Samprab06/PiPod/assets/demo_art/art_1.png

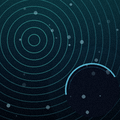
assets/demo_art/art_1.png
