Samprab06/PiPod/assets/demo_art/art_4.png

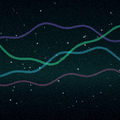
assets/demo_art/art_4.png
