Samprab06/PiPod/assets/demo_art/art_5.png

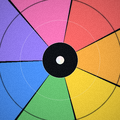
assets/demo_art/art_5.png
