Samprab06/PiPod/hardware/PiPod_BOM.csv

Category | References | Qty | Value | Manufacturer | MPN | Supplier | Supplier SKU | Datasheet URL | KiCad Symbol | KiCad Footprint | Package | Ratings | Populated/DNP | Verification Status | Notes
Mandatory | C1, C2, C3, C20 | 4 | 4.7u | KEMET | C0603C475K8PACTU | Digi-Key | 399-C0603C475K8PACTUTR-ND |  | Device:C | Capacitor_SMD:C_0603_1608Metric | 0603 | 10 V X5R | Populated | datasheet-checked | 2026-11-01/02 snapshot: stock 125,154; recheck before ordering
Mandatory | C4, C31, C32, C42, C43, C44, C50, C60, C71, C73, C75, C77 | 12 | 10u | Taiyo Yuden | EMK212ABJ106KD-T | Digi-Key |  |  | Device:C | Capacitor_SMD:C_0805_2012Metric | 0805 | 16 V X5R | Populated | datasheet-checked | 2026-11-01/02 snapshot: stock 55,760; recheck before ordering
Mandatory | C5, C6 | 2 | 15p | Murata | GRM1885C2A150JA01D | Digi-Key | 490-1331-2-ND |  | Device:C | Capacitor_SMD:C_0603_1608Metric | 0603 | 100 V C0G | Populated | datasheet-checked | 2026-11-01/02 snapshot: stock 645,869; recheck before ordering
Mandatory | C21, C33, C45, C46, C51, C61, C72, C74, C76, C78, C80, C100, C101, C102, C103, C104, C105, C106, C107, C108, C109, C110, C111, C112 | 24 | 100n | KEMET | C0603C104K4RACTU | Digi-Key |  |  | Device:C | Capacitor_SMD:C_0603_1608Metric | 0603 | 16 V X7R | Populated | datasheet-checked | 2026-11-01/02 snapshot: stock 7,248,230; recheck before ordering
Mandatory | C22, C40, C41, C79 | 4 | 22u | Taiyo Yuden | LMK212BJ226MG-T | Digi-Key | 587-1958-1-ND |  | Device:C | Capacitor_SMD:C_0805_2012Metric | 0805 | 10 V X5R | Populated | datasheet-checked | 2026-11-01/02 snapshot: stock 525,170, status Not For New Designs; recheck before ordering
Mandatory | C30, C70, C90, C91 | 4 | 1u | KEMET | C0603C105K4RACTU | Digi-Key |  |  | Device:C | Capacitor_SMD:C_0603_1608Metric | 0603 | 16 V X7R | Populated | datasheet-checked | 2026-11-01/02 snapshot: stock not read; recheck before ordering
Mandatory | C81, C82 | 2 | 100u | Taiyo Yuden | LMK325BJ107MM-T | Digi-Key | 587-1965-2-ND |  | Device:C | Capacitor_SMD:C_1210_3225Metric | 1210 | 10 V X5R | Populated | datasheet-checked | 2026-11-01/02 snapshot: stock 92,909; recheck before ordering
Mandatory | D1 | 1 | GREEN | Lite-On | LTST-C171KGKT | Digi-Key | 160-1426-2-ND |  | Device:LED | LED_SMD:LED_0805_2012Metric | 0805 |  | Populated | same part as Proton Rev4 | 2026-11-01/02 snapshot: stock 400,708; recheck before ordering
Mandatory | D2 | 1 | SMF5.0A | Littelfuse | SMF5.0A | Digi-Key |  |  | Device:D_Zener | Diode_SMD:D_SMF | SMF | 5 V standoff | Populated | needs human check | 2026-11-01/02 snapshot: stock not read; recheck before ordering
Mandatory | E1 | 1 | E0 |  |  |  |  |  | Connector:TestPoint | PiPod:WheelElectrode_Placeholder | PCB electrode |  | Populated | layout dependency | No part
Mandatory | E2 | 1 | E1 |  |  |  |  |  | Connector:TestPoint | PiPod:WheelElectrode_Placeholder | PCB electrode |  | Populated | layout dependency | No part
Mandatory | E3 | 1 | E2 |  |  |  |  |  | Connector:TestPoint | PiPod:WheelElectrode_Placeholder | PCB electrode |  | Populated | layout dependency | No part
Mandatory | E4 | 1 | E3 |  |  |  |  |  | Connector:TestPoint | PiPod:WheelElectrode_Placeholder | PCB electrode |  | Populated | layout dependency | No part
Mandatory | E5 | 1 | E4 |  |  |  |  |  | Connector:TestPoint | PiPod:WheelElectrode_Placeholder | PCB electrode |  | Populated | layout dependency | No part
Mandatory | E6 | 1 | E5 |  |  |  |  |  | Connector:TestPoint | PiPod:WheelElectrode_Placeholder | PCB electrode |  | Populated | layout dependency | No part
Mandatory | E7 | 1 | E6 |  |  |  |  |  | Connector:TestPoint | PiPod:WheelElectrode_Placeholder | PCB electrode |  | Populated | layout dependency | No part
Mandatory | E8 | 1 | E7 |  |  |  |  |  | Connector:TestPoint | PiPod:WheelElectrode_Placeholder | PCB electrode |  | Populated | layout dependency | No part
Mandatory | E9 | 1 | E8 |  |  |  |  |  | Connector:TestPoint | PiPod:WheelElectrode_Placeholder | PCB electrode |  | Populated | layout dependency | No part
Mandatory | E10 | 1 | E9 |  |  |  |  |  | Connector:TestPoint | PiPod:WheelElectrode_Placeholder | PCB electrode |  | Populated | layout dependency | No part
Mandatory | E11 | 1 | E10 |  |  |  |  |  | Connector:TestPoint | PiPod:WheelElectrode_Placeholder | PCB electrode |  | Populated | layout dependency | No part
Mandatory | E12 | 1 | E11 |  |  |  |  |  | Connector:TestPoint | PiPod:WheelElectrode_Placeholder | PCB electrode |  | Populated | layout dependency | No part
Mandatory | FB1 | 1 | BLM18KG601SN1D | Murata | BLM18KG601SN1D | Digi-Key | 490-5258-2-ND |  | Device:FerriteBead | Inductor_SMD:L_0603_1608Metric | 0603 | 600 ohm 1.3 A | Populated | check MPN | 2026-11-01/02 snapshot: stock 1,152,845; recheck before ordering
Mandatory | J1 | 1 | USB-C | GCT | USB4105-GF-A | Digi-Key |  | https://gct.co/files/drawings/usb4105.pdf | Connector:USB_C_Receptacle_USB2.0_16P | Connector_USB:USB_C_Receptacle_GCT_USB4105-xx-A_16P_TopMnt_Horizontal | USB-C |  | Populated | library footprint names this part | 2026-11-01/02 snapshot: stock not read; recheck before ordering
Mandatory | J2 | 1 | BATTERY | JST | S2B-PH-SM4-TB(LF)(SN) | Digi-Key |  |  | Connector_Generic_MountingPin:Conn_01x02_MountingPin | Connector_JST:JST_PH_S2B-PH-SM4-TB_1x02-1MP_P2.00mm_Horizontal | JST PH 2-pin |  | Populated | provisional | 2026-11-01/02 snapshot: comfortably stocked per snapshot; recheck before ordering
Mandatory | J4 | 1 | microSD | Hirose | DM3AT-SF-PEJM5(40) | Digi-Key |  |  | Connector:Micro_SD_Card_Det_Hirose_DM3AT | Connector_Card:microSD_HC_Hirose_DM3AT-SF-PEJM5 | microSD |  | Populated | library footprint names this part | 2026-11-01/02 snapshot: reel-packed, Mouser 16,013, unsuffixed code sold at Digi-Key, confirm which can be bought in small quantity; recheck before ordering
Mandatory | J5 | 1 | SJ2-35954D-SMT-TR | Same Sky | SJ2-35954D-SMT-TR | Digi-Key |  | https://www.sameskydevices.com/product/resource/sj2-3595x-smt.pdf | PiPod:SJ2-35954D | PiPod:Jack_3.5mm_SameSky_SJ2-35954D-SMT | 3.5 mm jack |  | Populated | custom footprint from drawing; needs human check | 2026-11-01/02 snapshot: stock 820; the Digi-Key datasheet link says discontinued while the status is Active, flag for confirmation; recheck before ordering
Mandatory | J8 | 1 | AUDIO_BACKUP | Sullins | PREC008DAAN-RC | Digi-Key | 35-PREC008DAAN-RC-ND |  | Connector_Generic:Conn_02x08_Odd_Even | Connector_PinHeader_2.54mm:PinHeader_2x08_P2.54mm_Vertical | 2x08 2.54 mm header |  | Populated | from module schematic; provisional | 2026-11-01/02 snapshot: stock 2,524; recheck before ordering
Mandatory | J10 | 1 | MOTOR | JST | SM02B-SRSS-TB(LF)(SN) | Digi-Key | 455-SM02B-SRSS-TBTR-ND |  | Connector_Generic_MountingPin:Conn_01x02_MountingPin | Connector_JST:JST_SH_SM02B-SRSS-TB_1x02-1MP_P1.00mm_Horizontal | JST SH 2-pin |  | Populated | library footprint | 2026-11-01/02 snapshot: stock 12,160; recheck before ordering
Mandatory | J11, J12 | 2 | QWIIC | JST | SM04B-SRSS-TB(LF)(SN) | Digi-Key |  |  | Connector_Generic_MountingPin:Conn_01x04_MountingPin | Connector_JST:JST_SH_SM04B-SRSS-TB_1x04-1MP_P1.00mm_Horizontal | JST SH 4-pin |  | Populated | library footprint; brief's MPN | 2026-11-01/02 snapshot: comfortably stocked per snapshot; recheck before ordering
Mandatory | J13 | 1 | EXPANSION | Sullins | PREC010SAAN-RC | Digi-Key | 35-PREC010SAAN-RC-ND |  | Connector_Generic:Conn_01x10 | Connector_PinHeader_2.54mm:PinHeader_1x10_P2.54mm_Vertical | 1x10 2.54 mm header |  | Populated | library footprint | 2026-11-01/02 snapshot: stock 1,236; recheck before ordering
Mandatory | J14 | 1 | DEBUG | Sullins | PREC006SAAN-RC | Digi-Key |  |  | Connector_Generic:Conn_01x06 | Connector_PinHeader_2.54mm:PinHeader_1x06_P2.54mm_Vertical | 1x06 2.54 mm header |  | Populated | library footprint | 2026-11-01/02 snapshot: stock 31,829; recheck before ordering
Mandatory | L1 | 1 | 3.3u | Abracon | AOTA-B201610S3R3-101-T | Arrow or Verical |  |  | Device:L | Inductor_SMD:L_Abracon_AOTA-B201610S | 2016 |  | Populated | named by Raspberry Pi guide | 2026-11-01/02 snapshot: no Digi-Key or Mouser offer, sourcing risk; recheck before ordering
Mandatory | L2 | 1 | 2.2u | Murata | DFE322512F-2R2M=P2 | Digi-Key | 490-DFE322512F-2R2M=P2TR-ND |  | Device:L | Inductor_SMD:L_1210_3225Metric | 1210 | 2.2 uH 2.6 A | Populated | substitute; check land pattern against Murata drawing | 2026-11-01/02 snapshot: stock 18,854; recheck before ordering
Mandatory | Q1 | 1 | 2N7002 | Nexperia | 2N7002 | Digi-Key |  |  | Transistor_FET:2N7002 | Package_TO_SOT_SMD:SOT-23 | SOT-23 |  | Populated | library symbol | 2026-11-01/02 snapshot: stock not read; recheck before ordering
Mandatory | Q2 | 1 | AO3401A | Alpha & Omega | AO3401A | Digi-Key |  |  | Transistor_FET:AO3401A | Package_TO_SOT_SMD:SOT-23 | SOT-23 |  | Populated | library symbol | 2026-11-01/02 snapshot: comfortably stocked per snapshot; recheck before ordering
Mandatory | R1, R2 | 2 | 27R | Yageo | RC0603FR-0727RL | Digi-Key |  |  | Device:R | Resistor_SMD:R_0603_1608Metric | 0603 |  | Populated | datasheet-checked | 2026-11-01/02 snapshot: standard catalog part, not individually checked; recheck before ordering
Mandatory | R3 | 1 | 33R | Yageo | RC0603FR-0733RL | Digi-Key |  |  | Device:R | Resistor_SMD:R_0603_1608Metric | 0603 |  | Populated | datasheet-checked | 2026-11-01/02 snapshot: standard catalog part, not individually checked; recheck before ordering
Mandatory | R4, R5, R6, R83 | 4 | 1k | Yageo | RC0603FR-071KL | Digi-Key |  |  | Device:R | Resistor_SMD:R_0603_1608Metric | 0603 |  | Populated | datasheet-checked | 2026-11-01/02 snapshot: standard catalog part, not individually checked; recheck before ordering
Mandatory | R10, R11 | 2 | 5.1k | Yageo | RC0603FR-075K1L | Digi-Key |  |  | Device:R | Resistor_SMD:R_0603_1608Metric | 0603 |  | Populated | datasheet-checked | 2026-11-01/02 snapshot: standard catalog part, not individually checked; recheck before ordering
Mandatory | R12, R44, R52, R60, R70, R71, R72, R73, R74, R75, R76, R85, R90, R94, R95, R97, R98, R99 | 18 | 0R | Yageo | RC0603JR-070RL | Digi-Key |  |  | Device:R | Resistor_SMD:R_0603_1608Metric | 0603 |  | Populated | datasheet-checked | 2026-11-01/02 snapshot: standard catalog part, not individually checked; recheck before ordering
Mandatory | R13, R40 | 2 | 300k | Yageo | RC0603FR-07300KL | Digi-Key |  |  | Device:R | Resistor_SMD:R_0603_1608Metric | 0603 |  | Populated | datasheet-checked | 2026-11-01/02 snapshot: standard catalog part, not individually checked; recheck before ordering
Mandatory | R14 | 1 | 80.6k | Yageo | RC0603FR-0780K6L | Digi-Key |  |  | Device:R | Resistor_SMD:R_0603_1608Metric | 0603 |  | Populated | datasheet-checked | 2026-11-01/02 snapshot: stock 153,921; recheck before ordering
Mandatory | R15, R16, R24, R41, R42, R43, R53, R54, R67, R77, R78, R81, R96, R108 | 14 | 100k | Yageo | RC0603FR-07100KL | Digi-Key |  |  | Device:R | Resistor_SMD:R_0603_1608Metric | 0603 |  | Populated | datasheet-checked | 2026-11-01/02 snapshot: standard catalog part, not individually checked; recheck before ordering
Mandatory | R17 | 1 | 47k | Yageo | RC0603FR-0747KL | Digi-Key |  |  | Device:R | Resistor_SMD:R_0603_1608Metric | 0603 |  | Populated | datasheet-checked | 2026-11-01/02 snapshot: standard catalog part, not individually checked; recheck before ordering
Mandatory | R20, R25 | 2 | 0R | Yageo | RC0805JR-070RL | Digi-Key |  |  | Device:R | Resistor_SMD:R_0805_2012Metric | 0805 |  | Populated | datasheet-checked | 2026-11-01/02 snapshot: standard catalog part, not individually checked; recheck before ordering
Mandatory | R21 | 1 | 1.78k | Yageo | RC0603FR-071K78L | Digi-Key |  |  | Device:R | Resistor_SMD:R_0603_1608Metric | 0603 |  | Populated | datasheet-checked | 2026-11-01/02 snapshot: standard catalog part, not individually checked; recheck before ordering
Mandatory | R22, R27, R28, R61, R62, R63, R64, R65, R100, R101, R102, R103, R104 | 13 | 10k | Yageo | RC0603FR-0710KL | Digi-Key |  |  | Device:R | Resistor_SMD:R_0603_1608Metric | 0603 |  | Populated | datasheet-checked | 2026-11-01/02 snapshot: standard catalog part, not individually checked; recheck before ordering
Mandatory | R23 | 1 | 1.58k | Yageo | RC0603FR-071K58L | Digi-Key |  |  | Device:R | Resistor_SMD:R_0603_1608Metric | 0603 |  | Populated | datasheet-checked | 2026-11-01/02 snapshot: standard catalog part, not individually checked; recheck before ordering
Mandatory | R29, R30, R47, R48 | 4 | 1M | Yageo | RC0603FR-071ML | Digi-Key |  |  | Device:R | Resistor_SMD:R_0603_1608Metric | 0603 |  | Populated | datasheet-checked | 2026-11-01/02 snapshot: standard catalog part, not individually checked; recheck before ordering
Mandatory | R46 | 1 | 100 | Yageo | RC0603FR-07100RL | Digi-Key |  |  | Device:R | Resistor_SMD:R_0603_1608Metric | 0603 |  | Populated | datasheet-checked | 2026-11-01/02 snapshot: standard catalog part, not individually checked; recheck before ordering
Mandatory | R50, R51, R66 | 3 | 22R | Yageo | RC0603FR-0722RL | Digi-Key |  |  | Device:R | Resistor_SMD:R_0603_1608Metric | 0603 |  | Populated | datasheet-checked | 2026-11-01/02 snapshot: standard catalog part, not individually checked; recheck before ordering
Mandatory | R79, R82, R110, R111 | 4 | 4.7k | Yageo | RC0603FR-074K7L | Digi-Key |  |  | Device:R | Resistor_SMD:R_0603_1608Metric | 0603 |  | Populated | datasheet-checked | 2026-11-01/02 snapshot: standard catalog part, not individually checked; recheck before ordering
Mandatory | R84 | 1 | 2.2k | Yageo | RC0603FR-072K2L | Digi-Key |  |  | Device:R | Resistor_SMD:R_0603_1608Metric | 0603 |  | Populated | datasheet-checked | 2026-11-01/02 snapshot: standard catalog part, not individually checked; recheck before ordering
Mandatory | SW1, SW2 | 2 | BOOTSEL / RESET | C&K | PTS647SM38SMTR2LFS | Digi-Key |  |  | Switch:SW_Push | Button_Switch_SMD:SW_SPST_PTS647_Sx38 | PTS647 |  | Populated | same part as Proton Rev4 | 2026-11-01/02 snapshot: stock not read; recheck before ordering
Mandatory | TP1 | 1 | VBUS_RAW |  |  |  |  |  | Connector:TestPoint | TestPoint:TestPoint_Pad_D1.5mm | 1.5 mm pad |  | Populated | library footprint | No part
Mandatory | TP2 | 1 | USB_5V |  |  |  |  |  | Connector:TestPoint | TestPoint:TestPoint_Pad_D1.5mm | 1.5 mm pad |  | Populated | library footprint | No part
Mandatory | TP3 | 1 | VBAT |  |  |  |  |  | Connector:TestPoint | TestPoint:TestPoint_Pad_D1.5mm | 1.5 mm pad |  | Populated | library footprint | No part
Mandatory | TP4 | 1 | CHG_OUT |  |  |  |  |  | Connector:TestPoint | TestPoint:TestPoint_Pad_D1.5mm | 1.5 mm pad |  | Populated | library footprint | No part
Mandatory | TP5 | 1 | VSYS |  |  |  |  |  | Connector:TestPoint | TestPoint:TestPoint_Pad_D1.5mm | 1.5 mm pad |  | Populated | library footprint | No part
Mandatory | TP6 | 1 | +3V3 |  |  |  |  |  | Connector:TestPoint | TestPoint:TestPoint_Pad_D1.5mm | 1.5 mm pad |  | Populated | library footprint | No part
Mandatory | TP7 | 1 | +1V1 |  |  |  |  |  | Connector:TestPoint | TestPoint:TestPoint_Pad_D1.5mm | 1.5 mm pad |  | Populated | library footprint | No part
Mandatory | TP8 | 1 | 3V3_A |  |  |  |  |  | Connector:TestPoint | TestPoint:TestPoint_Pad_D1.5mm | 1.5 mm pad |  | Populated | library footprint | No part
Mandatory | TP9 | 1 | 1V8_A |  |  |  |  |  | Connector:TestPoint | TestPoint:TestPoint_Pad_D1.5mm | 1.5 mm pad |  | Populated | library footprint | No part
Mandatory | TP10 | 1 | GND |  |  |  |  |  | Connector:TestPoint | TestPoint:TestPoint_Pad_D1.5mm | 1.5 mm pad |  | Populated | library footprint | No part
Mandatory | TP11 | 1 | SWDIO |  |  |  |  |  | Connector:TestPoint | TestPoint:TestPoint_Pad_D1.5mm | 1.5 mm pad |  | Populated | library footprint | No part
Mandatory | TP12 | 1 | SWCLK |  |  |  |  |  | Connector:TestPoint | TestPoint:TestPoint_Pad_D1.5mm | 1.5 mm pad |  | Populated | library footprint | No part
Mandatory | TP13 | 1 | RUN |  |  |  |  |  | Connector:TestPoint | TestPoint:TestPoint_Pad_D1.5mm | 1.5 mm pad |  | Populated | library footprint | No part
Mandatory | TP14 | 1 | I2C0_SDA |  |  |  |  |  | Connector:TestPoint | TestPoint:TestPoint_Pad_D1.5mm | 1.5 mm pad |  | Populated | library footprint | No part
Mandatory | TP15 | 1 | I2C0_SCL |  |  |  |  |  | Connector:TestPoint | TestPoint:TestPoint_Pad_D1.5mm | 1.5 mm pad |  | Populated | library footprint | No part
Mandatory | TP16 | 1 | DISP_SCK |  |  |  |  |  | Connector:TestPoint | TestPoint:TestPoint_Pad_D1.5mm | 1.5 mm pad |  | Populated | library footprint | No part
Mandatory | TP17 | 1 | DISP_MOSI |  |  |  |  |  | Connector:TestPoint | TestPoint:TestPoint_Pad_D1.5mm | 1.5 mm pad |  | Populated | library footprint | No part
Mandatory | TP18 | 1 | DISP_CS |  |  |  |  |  | Connector:TestPoint | TestPoint:TestPoint_Pad_D1.5mm | 1.5 mm pad |  | Populated | library footprint | No part
Mandatory | TP19 | 1 | SD_SCK |  |  |  |  |  | Connector:TestPoint | TestPoint:TestPoint_Pad_D1.5mm | 1.5 mm pad |  | Populated | library footprint | No part
Mandatory | TP20 | 1 | SD_MOSI |  |  |  |  |  | Connector:TestPoint | TestPoint:TestPoint_Pad_D1.5mm | 1.5 mm pad |  | Populated | library footprint | No part
Mandatory | TP21 | 1 | SD_MISO |  |  |  |  |  | Connector:TestPoint | TestPoint:TestPoint_Pad_D1.5mm | 1.5 mm pad |  | Populated | library footprint | No part
Mandatory | TP22 | 1 | SD_CS |  |  |  |  |  | Connector:TestPoint | TestPoint:TestPoint_Pad_D1.5mm | 1.5 mm pad |  | Populated | library footprint | No part
Mandatory | TP23 | 1 | I2S_BCLK |  |  |  |  |  | Connector:TestPoint | TestPoint:TestPoint_Pad_D1.5mm | 1.5 mm pad |  | Populated | library footprint | No part
Mandatory | TP24 | 1 | I2S_LRCLK |  |  |  |  |  | Connector:TestPoint | TestPoint:TestPoint_Pad_D1.5mm | 1.5 mm pad |  | Populated | library footprint | No part
Mandatory | TP25 | 1 | I2S_DOUT |  |  |  |  |  | Connector:TestPoint | TestPoint:TestPoint_Pad_D1.5mm | 1.5 mm pad |  | Populated | library footprint | No part
Mandatory | TP26 | 1 | TOUCH_IRQ |  |  |  |  |  | Connector:TestPoint | TestPoint:TestPoint_Pad_D1.5mm | 1.5 mm pad |  | Populated | library footprint | No part
Mandatory | TP27 | 1 | HAPTIC_EN |  |  |  |  |  | Connector:TestPoint | TestPoint:TestPoint_Pad_D1.5mm | 1.5 mm pad |  | Populated | library footprint | No part
Mandatory | TP28 | 1 | HP_L |  |  |  |  |  | Connector:TestPoint | TestPoint:TestPoint_Pad_D1.5mm | 1.5 mm pad |  | Populated | library footprint | No part
Mandatory | TP29 | 1 | HP_R |  |  |  |  |  | Connector:TestPoint | TestPoint:TestPoint_Pad_D1.5mm | 1.5 mm pad |  | Populated | library footprint | No part
Mandatory | TP30 | 1 | USB_FAULT_N |  |  |  |  |  | Connector:TestPoint | TestPoint:TestPoint_Pad_D1.5mm | 1.5 mm pad |  | Populated | library footprint | No part
Mandatory | TP31 | 1 | MUX_ST |  |  |  |  |  | Connector:TestPoint | TestPoint:TestPoint_Pad_D1.5mm | 1.5 mm pad |  | Populated | library footprint | No part
Mandatory | U1 | 1 | RP2354B | Raspberry Pi | SC1512-A4 | Digi-Key |  | https://datasheets.raspberrypi.com/rp2350/rp2350-datasheet.pdf | MCU_RaspberryPi:RP2354B | Package_DFN_QFN:QFN-80-1EP_10x10mm_P0.4mm_EP3.4x3.4mm | QFN-80 |  | Populated | datasheet-checked; footprint needs human check | 2026-11-01/02 snapshot: Digi-Key stock 3,515, Mouser 1,039, 22-week lead time; recheck before ordering
Mandatory | U2, U7, U8 | 3 | USBLC6-2SC6 | STMicroelectronics | USBLC6-2SC6 | Digi-Key |  | https://www.st.com/resource/en/datasheet/usblc6-2.pdf | Power_Protection:USBLC6-2SC6 | Package_TO_SOT_SMD:SOT-23-6 | SOT-23-6 |  | Populated | same family as Proton Rev4; datasheet not re-downloaded | 2026-11-01/02 snapshot: comfortably stocked per snapshot; recheck before ordering
Mandatory | U3 | 1 | TPS25200 | Texas Instruments | TPS25200DRVR | Digi-Key |  | https://www.ti.com/lit/ds/symlink/tps25200.pdf | PiPod:TPS25200 | Package_SON:WSON-6-1EP_2x2mm_P0.65mm_EP1x1.6mm | WSON-6 |  | Populated | datasheet-checked; custom symbol | 2026-11-01/02 snapshot: stock only 11, buy early; recheck before ordering
Mandatory | U4 | 1 | BQ24074 | Texas Instruments | BQ24074RGTR | Digi-Key |  | https://www.ti.com/lit/ds/symlink/bq24074.pdf | Battery_Management:BQ24074RGT | Package_DFN_QFN:VQFN-16-1EP_3x3mm_P0.5mm_EP1.6x1.6mm | VQFN-16 |  | Populated | datasheet-checked; check EP against RGT0016B drawing | 2026-11-01/02 snapshot: status Active; recheck before ordering
Mandatory | U5 | 1 | TPS2116 | Texas Instruments | TPS2116DRLR | Digi-Key |  | https://www.ti.com/lit/ds/symlink/tps2116.pdf | Power_Management:TPS2116DRL | Package_TO_SOT_SMD:SOT-583-8 | SOT-583 |  | Populated | datasheet-checked | 2026-11-01/02 snapshot: stock 177; recheck before ordering
Mandatory | U6 | 1 | TPS63001 | Texas Instruments | TPS63001DRCR | Digi-Key |  | https://www.ti.com/lit/ds/symlink/tps63001.pdf | Regulator_Switching:TPS63001 | Package_SON:Texas_DRC0010J | VSON-10 |  | Populated | datasheet-checked | 2026-11-01/02 snapshot: stock 17,671, Mouser 0; recheck before ordering
Mandatory | U9 | 1 | TLV320DAC3100 | Texas Instruments | TLV320DAC3100IRHBR | Digi-Key |  | https://www.ti.com/lit/ds/symlink/tlv320dac3100.pdf | PiPod:TLV320DAC3100 | Package_DFN_QFN:Texas_RHB0032E_VQFN-32-1EP_5x5mm_P0.5mm_EP3.45x3.45mm | VQFN-32 |  | Populated | datasheet-checked; custom symbol | 2026-11-01/02 snapshot: stock not read; recheck before ordering
Mandatory | U10 | 1 | AP2112K-1.8 | Diodes Inc. | AP2112K-1.8TRG1 | Digi-Key |  |  | Regulator_Linear:AP2112K-1.8 | Package_TO_SOT_SMD:SOT-23-5 | SOT-23-5 |  | Populated | same family as Proton Rev4 | 2026-11-01/02 snapshot: comfortably stocked per snapshot; recheck before ordering
Mandatory | U11 | 1 | DRV2605L | Texas Instruments | DRV2605LDGST | Digi-Key |  | https://www.ti.com/lit/ds/symlink/drv2605l.pdf | Driver:DRV2605LDGS | Package_SO:TSSOP-10_3x3mm_P0.5mm | TSSOP-10 |  | Populated | datasheet-checked; check land pattern | 2026-11-01/02 snapshot: stock 2,475, Mouser 2,007; recheck before ordering
Mandatory | Y1 | 1 | 12MHz | Abracon | ABM8-272-T3 | Digi-Key |  |  | Device:Crystal_GND24 | Crystal:Crystal_SMD_3225-4Pin_3.2x2.5mm | 3225 |  | Populated | named by Raspberry Pi guide | 2026-11-01/02 snapshot: constrained supply; recheck before ordering
Optional/DNP | J6 | 1 | SPEAKER | JST | S2B-PH-SM4-TB(LF)(SN) | Digi-Key |  |  | Connector_Generic_MountingPin:Conn_01x02_MountingPin | Connector_JST:JST_PH_S2B-PH-SM4-TB_1x02-1MP_P2.00mm_Horizontal | JST PH 2-pin |  | DNP | provisional | 2026-11-01/02 snapshot: comfortably stocked per snapshot; recheck before ordering
Optional/DNP | R26 | 1 | 0R | Yageo | RC0805JR-070RL | Digi-Key |  |  | Device:R | Resistor_SMD:R_0805_2012Metric | 0805 |  | DNP | datasheet-checked | 2026-11-01/02 snapshot: standard catalog part, not individually checked; recheck before ordering
Optional/DNP | R45, R80, R91, R92, R93, R112 | 6 | 0R | Yageo | RC0603JR-070RL | Digi-Key |  |  | Device:R | Resistor_SMD:R_0603_1608Metric | 0603 |  | DNP | datasheet-checked | 2026-11-01/02 snapshot: standard catalog part, not individually checked; recheck before ordering
Mechanical | J3 | 1 | DISPLAY | Sullins | PPTC091LFBN-RC | Digi-Key | S7007-ND |  | Connector_Generic:Conn_01x09 | Connector_PinSocket_2.54mm:PinSocket_1x09_P2.54mm_Vertical | 1x09 2.54 mm socket |  | Populated | provisional pin order | 2026-11-01/02 snapshot: stock not read; recheck before ordering
Mechanical | J7 | 1 | MPR121_CTRL | Sullins | PPTC071LFBN-RC | Digi-Key | S7005-ND |  | Connector_Generic:Conn_01x07 | Connector_PinSocket_2.54mm:PinSocket_1x07_P2.54mm_Vertical | 1x07 2.54 mm socket |  | Populated | checked against Adafruit board file | 2026-11-01/02 snapshot: stock not read; recheck before ordering
Mechanical | J9 | 1 | MPR121_ELEC | Sullins | PPTC131LFBN-RC | Digi-Key | S7011-ND |  | Connector_Generic:Conn_01x13 | Connector_PinSocket_2.54mm:PinSocket_1x13_P2.54mm_Vertical | 1x13 2.54 mm socket |  | Populated | checked against Adafruit board file | 2026-11-01/02 snapshot: stock 1,180; recheck before ordering
Mechanical | SW3 | 1 | POWER | C&K | JS102011SAQN | Digi-Key | 401-1999-2-ND |  | Switch:SW_SPDT | Button_Switch_SMD:SW_SPDT_CK_JS102011SAQN | SMD slide switch |  | Populated | provisional mechanical | 2026-11-01/02 snapshot: stock 53,695; recheck before ordering
Mechanical | SW4, SW5, SW6, SW7, SW8 | 5 | MENU / PLAY / PREV / NEXT / SELECT | C&K | PTS647SM38SMTR2LFS | Digi-Key |  |  | Switch:SW_Push | Button_Switch_SMD:SW_SPST_PTS647_Sx38 | PTS647 |  | Populated | provisional mechanical | 2026-11-01/02 snapshot: stock not read; recheck before ordering
External modules and Off-board |  | 1 | MPR121 capacitive touch module | Adafruit | 1982 | Adafruit |  |  |  |  | breakout module |  | Off-board | provisional | I2C address 0x5B set by R90; plugs into J7 and J9; not on the board; recheck before ordering
External modules and Off-board |  | 1 | DAC test board | Adafruit | 6309 | Adafruit |  |  |  |  | breakout board |  | Off-board | provisional | audio path test board; not on the board; recheck before ordering
External modules and Off-board |  | 1 | WM8960 audio board | Waveshare |  | Waveshare |  |  |  |  | module |  | Off-board | provisional | backup codec module; header mapping from the module schematic; not on the board; recheck before ordering
External modules and Off-board |  | 1 | 2.2 in ILI9341 SPI module |  |  |  |  |  |  |  | module |  | Off-board | provisional | pin order unconfirmed; not on the board; recheck before ordering
External modules and Off-board |  | 1 | 1000 mAh protected LiPo, 2-pin JST-PH |  |  |  |  |  |  |  | JST-PH 2-pin |  | Off-board | provisional | capacity and connector assumed; polarity to confirm; recheck before ordering
External modules and Off-board |  | 1 | ERM coin motor, 3.3 V |  |  |  |  |  |  |  |  |  | Off-board | provisional | not selected; must be rated for 3.3 V; recheck before ordering
External modules and Off-board |  | 1 | Qwiic cable, 4-pin JST-SH |  |  |  |  |  |  |  | JST-SH 4-pin |  | Off-board | provisional | 4-pin JST-SH cable; recheck before ordering
