Samprab06/PiPod/hardware/integration_guide.md

# PiPod schematic integration guide

For the person turning this draft into the final schematic. It covers what exists, what's still undecided, and the order to work through it.

**Status: draft, not cleared for fabrication.** The KiCad checks pass, but no board has been built and these sheets were generated by script. Please review them as you would a stranger's first pass.

## What's here

| Path | What it is |
|---|---|
| `PiPod.kicad_pro` | Open this one. Don't open a single sheet on its own |
| `PiPod.kicad_sch`, `01_...` to `11_...kicad_sch` | Root sheet and 11 subsystem sheets |
| `lib/PiPod.kicad_sym`, `lib/PiPod.pretty/` | Custom symbols and footprints |
| `PiPod_BOM.csv` | Engineering BOM with supplier notes and verification status |
| `docs/design_overview.md` | Architecture, rails, current budget, charger math, fault table, audio clocks, I2C, isolation |
| `docs/pin_map.md` | Every GPIO: package pin, net, function, direction, status |
| `docs/layout_handoff.md` | Notes for the PCB layout engineer |
| `docs/verification_report.md` | What was and wasn't checked, and the full risk list |
| `schematic.md` | Detailed handoff for another agent, including how the draft was made |

You need **KiCad 10**. KiCad 9 can't open these files.

## What was built

The board is a battery-powered music player based on the RP2354B:

- **Power:** USB-C feeds a BQ24074 charger and a separate TPS25200 fallback path. A TPS2116 mux picks the source, and a TPS63001 buck-boost makes 3.3 V.
- **Audio:** TLV320DAC3100 with a 4-pole headphone jack, unpopulated speaker pads, and a Waveshare WM8960 backup header.
- **Display:** socket for the 2.2-inch ILI9341 module, with a MOSFET backlight switch.
- **Storage:** microSD on SPI1.
- **Wheel:** Adafruit 1982 MPR121 module in sockets. PCB touch pads route to the sockets, and I2C runs over Qwiic.
- **Controls and haptics:** five buttons and a DRV2605L with a motor connector.
- **Service access:** two Qwiic ports, a 10-pin expansion header, an SWD and UART header, and test points.

**Build plan:** 4-layer OSH Park boards, hand assembled, with every component 0603 or larger.

## Changes from the original brief

The team approved all of these. Make sure anyone reading the brief knows about them.

| Brief | This draft | Why |
|---|---|---|
| WM8960 on the board | TLV320DAC3100, WM8960 module as backup | Digi-Key lists the WM8960 as obsolete |
| Integrated MPR121 | Adafruit module with Qwiic | NXP discontinued the MPR121; team choice |
| Brief's GPIO table | New map in `docs/pin_map.md` | Keeps the firmware's display pins and frees HSTX |

These detailed design choices were made after that approval. Check that you agree with them:

- GP11 reads headphone detect, GP44 reads the mux status, GP45 and GP46 control the charger, and GP47 drives a status LED.
- The slide switch turns off the regulator through its EN pin, instead of cutting battery power. A very small battery drain remains, and charging still works with the switch off.
- There's no Bluetooth, fuel gauge, accelerometer or RTC. The team gave no preference, so these have no footprints; add them over Qwiic or through the expansion header.

## Decisions needed before the schematic is final

1. **Display pin order:** J3 follows the pin list the team gave, not a datasheet. Compare it with your module, and check whether the module has its own LED resistor. R52 is a 0 Ω link you can change.
2. **Battery:** a 1000 mAh protected cell on JST-PH is only an assumption. Check polarity against your real cell, because vendors differ. If the cell has a thermistor, rework R22 and the connector. Charge current is set by R21: `R21 = 890 / I_charge`.
3. **Motor:** none is selected. It must suit 3.3 V, so check its voltage and current against the DRV2605L.
4. **Mechanical:** wheel diameter, overlay, button arrangement, display position and enclosure. The buttons are provisional PTS647 switches.
5. **Waveshare header (J8):** the pins come from the module's schematic. Decide how it physically connects.
6. **Assembly:** you need a stencil, reflow or hot air, and magnification for the 0.4 mm QFN-80. If you can't do that, the plan needs to change before layout.

## Bench tests worth doing first

These can change the schematic, so do them before layout.

1. **Audio:** connect an Adafruit 6309 to the Proton on GP6-8 and GP4-5, and play 44.1 kHz audio from PIO. Listen for jitter. If it's bad, fit R80 for MCLK from GP21 or choose a system clock that divides exactly.
2. **Touch:** plug an Adafruit 1982 into a test wheel. Confirm the module's orientation in J7 and J9 and whether sensing works through your overlay.
3. **Display:** confirm 75 MHz works through the 22 Ω series resistors.

## How to do the review

1. Open `PiPod.kicad_pro`. Let KiCad resolve libraries; `${KIPRJMOD}` paths point at `lib/`.
2. Read `docs/verification_report.md`.
3. Go through the sheets in this order: 04, 03, 02, 01, then 07, 05, 06, 08, 09, 10, 11. Power comes first, since everything depends on it.
4. For each IC, compare the pins and values with the datasheet links in `docs/design_overview.md`. These need the closest look:
   - **U1 pins:** GP38-39 and GP41-46 weren't fully confirmed against the datasheet.
   - **C22:** the 22 uF on U3's output needs confirming against the TPS25200 PDF.
   - **U2, U7, U8, D2:** the USBLC6 and SMF5.0A datasheets weren't re-read for this draft.
5. Compare these footprints with their manufacturer drawings at 1:1 (in `lib/PiPod.pretty/` where noted):
   - **J5:** `lib/PiPod.pretty/Jack_3.5mm_SameSky_SJ2-35954D-SMT.kicad_mod`. I measured the pad centers from a drawing image.
   - **L2:** generic 1210 footprint versus Murata's land pattern.
   - **U4:** KiCad's 1.6 mm thermal pad versus TI's RGT0016B drawing.
   - **U1, U3, U11, J1, J4, and the Qwiic and battery connectors:** library footprints, not compared by hand.
6. Run ERC in KiCad. It should be clean. Investigate anything new rather than excluding it.

## Working on the sheets

- **The drawing style is plain.** Every pin has a short wire and a net label, and parts sit in rows rather than signal flow. It's correct to read but not how a person would draw it. Rearrange anything you like: moving symbols and labels doesn't change the connections.
- **Global labels connect the sheets.** A net with the same name on two sheets is one net. Renaming on one sheet disconnects it, so rename everywhere.
- **Reference designators aren't sequential.** They're grouped by sheet. Annotate only if you want to, and if so, update references in the docs and sheet notes, which name many parts (such as "remove R70-R74").
- **Each sheet's notes** explain the values and removal steps. Update them when you change a circuit.
- **Fields:** each part has MPN, Manufacturer and Verification fields. Keep them filled in, since the BOM depends on them.
- **Edit the KiCad files directly.** The scripts that made the draft are in `hw_gen/`, but you don't need them. Once you've edited in KiCad, nobody should run them again, because `design.py` and `verify.py` regenerate the sheets and would overwrite your work.
- **Keep the BOM current by hand.** `PiPod_BOM.csv` won't update itself. KiCad's own BOM export is a useful cross-check.

## Rules to keep when changing circuits

- Keep the RP2350 regulator parts: the 3.3 uH Abracon inductor with its polarity marking, and 4.7 uF capacitors. The guide warns against departing from its layout. We're already off it with 0603 parts.
- Keep the ABM8-272-T3 crystal with 15 pF and 1 kΩ. The guide says other crystals need extensive testing.
- Don't add QSPI flash without approval. If you ever do, the guide explains the chip-select wiring and the required pull-up.
- Keep main I2C pull-ups on the MCU side of the 0 Ω links. Don't fit R26 unless U4 is removed.
- Don't ground HP_L, HP_R, SPK_P or SPK_M. Keep the DAC's headphone capacitors.
- Keep the MPR121 module at 0x5B (R90), or it clashes with the DRV2605L.
- Treat 0 Ω links as removal points, not protection.

## Sourcing

Stock numbers in the BOM are snapshots from this weekend, so recheck them. Order these early:

- **AOTA-B201610S3R3-101-T (L1):** no Digi-Key or Mouser offer, only Arrow and Verical. It's named by Raspberry Pi, so plan ahead.
- **TPS25200DRVR:** only 11 showed at Digi-Key.
- **TPS2116DRLR:** 177 at Digi-Key.
- **ABM8-272-T3:** constrained supply.
- **SC1512-A4 (RP2354B):** check you can buy small quantities.
- **DM3AT-SF-PEJM5:** the (40) suffix is reel-packed, so confirm which code you can buy in small quantities.
- **SJ2-35954D-SMT-TR:** Digi-Key shows Active but links a datasheet path marked "discontinued".

## Going to layout

1. Finish the decisions above and rerun ERC.
2. Set OSH Park's 4-layer rules in Board Setup: 5 mil trace and space, 10 mil drill, 4 mil annular ring, no blind or buried vias. Their docs are [here](https://docs.oshpark.com/services/four-layer).
3. Use **Update PCB from Schematic**. `PiPod.kicad_pcb` is currently empty.
4. Follow `docs/layout_handoff.md`. Replace electrode placeholders E1-E12 with real wheel copper.
5. Ask OSH Park about J1's plated slots, and send Gerbers rather than the KiCad 10 board file. Their docs list KiCad 9.x processing.

## Firmware that has to change

The firmware isn't on this branch. It's on the `display-ui` branch on GitHub, including the media and flash-streaming work, and that work isn't merged to `main`. For this board it needs:

- New pin assignments from `docs/pin_map.md`. The display pins already match.
- A TLV320DAC3100 driver and PIO I2S output, plus a separate WM8960 path if the backup is used.
- Songs moved from flash to microSD. The current flash layout assumes 16 MB and the RP2354B has 2 MB.
- Charger control, battery monitoring and headphone detect.

## Getting back the earlier schematic

This draft replaced Samridh's `PiPod.kicad_sch`, which is still on `main`:

```bash
git show origin/main:hardware/PiPod.kicad_sch > PiPod_samridh.kicad_sch
```

On `temp`, the stale lock file and the `hardware/.history` link were removed, and `.gitignore` now keeps KiCad's local files out of git. Keep that when you merge.
