Samprab06/PiPod/hardware/01_rp2354b_core.kicad_sch

## KiCad design hardware/01_rp2354b_core.kicad_sch (2026-11-02)

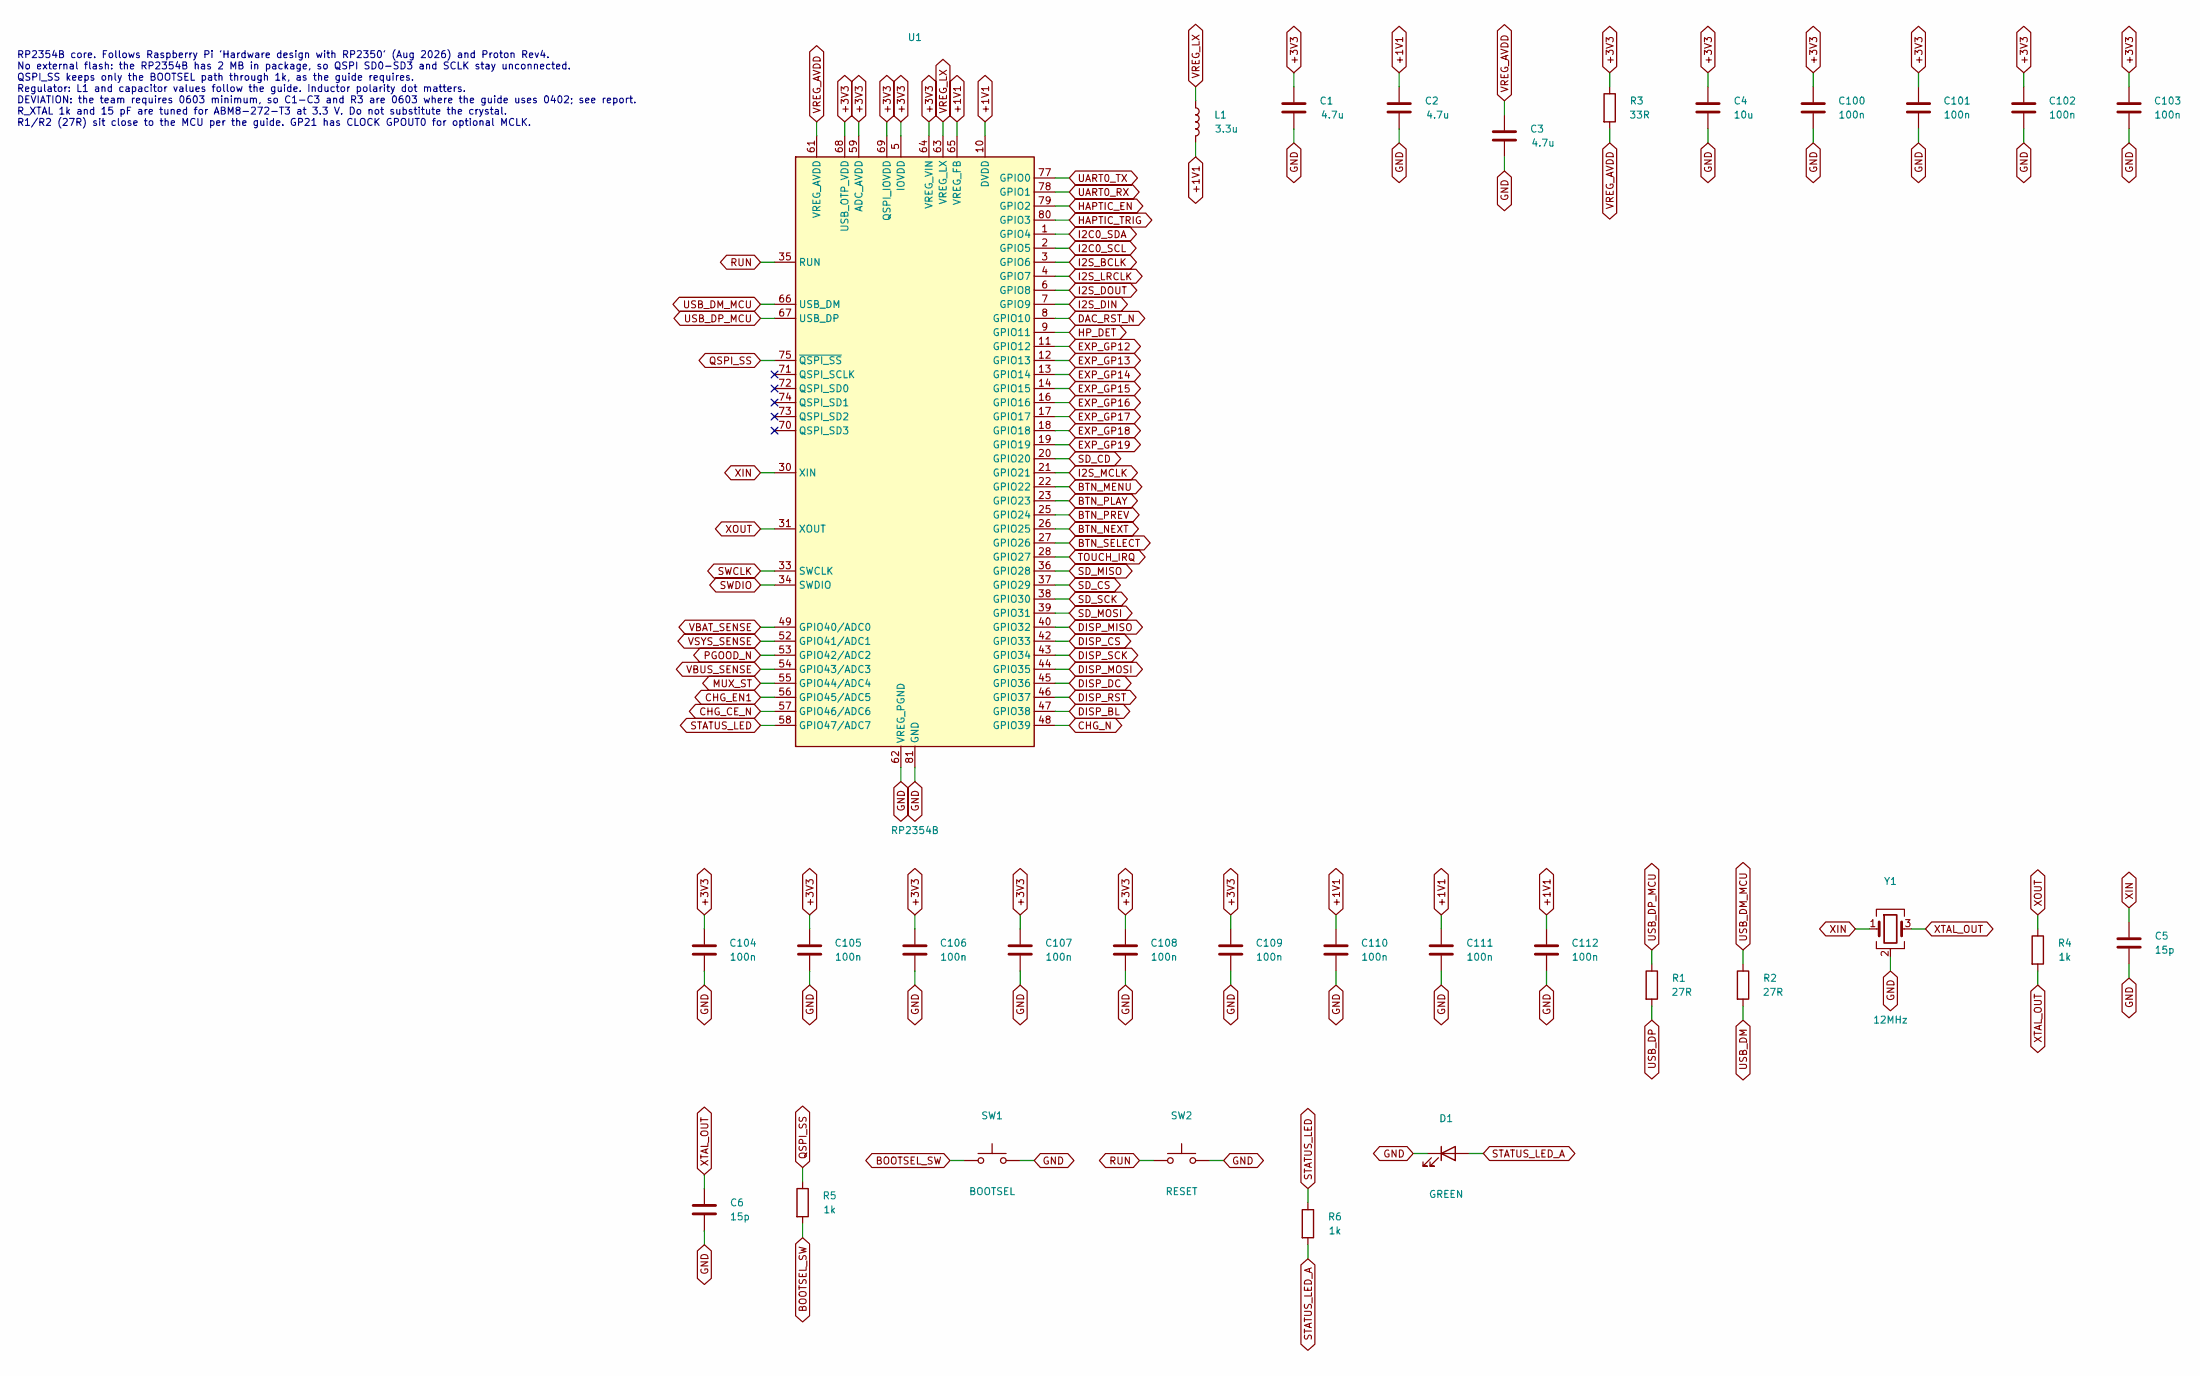
[picture p4: schematic 01_rp2354b_core.kicad_sch]

Parts:
C1, C2, C3: 4.7u; C_0603_1608Metric; MPN C0603C475K8PACTU
C4: 10u; C_0805_2012Metric; MPN EMK212ABJ106KD-T
C5, C6: 15p; C_0603_1608Metric; MPN GRM1885C2A150JA01D
C100, C101, C102, C103, C104, C105, C106, C107, C108, C109, C110, C111, C112: 100n; C_0603_1608Metric; MPN C0603C104K4RACTU
D1: GREEN; LED_0805_2012Metric; MPN LTST-C171KGKT
L1: 3.3u; L_Abracon_AOTA-B201610S; MPN AOTA-B201610S3R3-101-T
R1, R2: 27R; R_0603_1608Metric; MPN RC0603FR-0727RL
R3: 33R; R_0603_1608Metric; MPN RC0603FR-0733RL
R4, R5, R6: 1k; R_0603_1608Metric; MPN RC0603FR-071KL
SW1: BOOTSEL; SW_SPST_PTS647_Sx38; MPN PTS647SM38SMTR2LFS
SW2: RESET; SW_SPST_PTS647_Sx38; MPN PTS647SM38SMTR2LFS
U1: RP2354B; QFN-80-1EP_10x10mm_P0.4mm_EP3.4x3.4mm; MPN SC1512-A4
Y1: 12MHz; Crystal_SMD_3225-4Pin_3.2x2.5mm; MPN ABM8-272-T3

Connections:
+1V1: C2.1, C110.1, C111.1, C112.1, L1.2, U1.10 (DVDD), U1.32 (DVDD), U1.51 (DVDD), U1.65 (VREG_FB)
+3V3: C1.1, C4.1, C100.1, C101.1, C102.1, C103.1, C104.1, C105.1, C106.1, C107.1, C108.1, C109.1, R3.1, U1.5 (IOVDD), U1.15 (IOVDD), U1.24 (IOVDD), U1.29 (IOVDD), U1.41 (IOVDD), U1.50 (IOVDD), U1.59 (ADC_AVDD), U1.60 (IOVDD), U1.64 (VREG_VIN), U1.68 (USB_OTP_VDD), U1.69 (QSPI_IOVDD), U1.76 (IOVDD)
BOOTSEL_SW: R5.2, SW1.1
BTN_MENU: U1.22 (GPIO22)
BTN_NEXT: U1.26 (GPIO25)
BTN_PLAY: U1.23 (GPIO23)
BTN_PREV: U1.25 (GPIO24)
BTN_SELECT: U1.27 (GPIO26)
CHG_CE_N: U1.57 (GPIO46/ADC6)
CHG_EN1: U1.56 (GPIO45/ADC5)
CHG_N: U1.48 (GPIO39)
DAC_RST_N: U1.8 (GPIO10)
DISP_BL: U1.47 (GPIO38)
DISP_CS: U1.42 (GPIO33)
DISP_DC: U1.45 (GPIO36)
DISP_MISO: U1.40 (GPIO32)
DISP_MOSI: U1.44 (GPIO35)
DISP_RST: U1.46 (GPIO37)
DISP_SCK: U1.43 (GPIO34)
EXP_GP12: U1.11 (GPIO12)
EXP_GP13: U1.12 (GPIO13)
EXP_GP14: U1.13 (GPIO14)
EXP_GP15: U1.14 (GPIO15)
EXP_GP16: U1.16 (GPIO16)
EXP_GP17: U1.17 (GPIO17)
EXP_GP18: U1.18 (GPIO18)
EXP_GP19: U1.19 (GPIO19)
GND: C1.2, C2.2, C3.2, C4.2, C5.2, C6.2, C100.2, C101.2, C102.2, C103.2, C104.2, C105.2, C106.2, C107.2, C108.2, C109.2, C110.2, C111.2, C112.2, D1.1 (K), SW1.2, SW2.2, U1.62 (VREG_PGND), U1.81 (GND), Y1.2 (G), Y1.4 (G)
HAPTIC_EN: U1.79 (GPIO2)
HAPTIC_TRIG: U1.80 (GPIO3)
HP_DET: U1.9 (GPIO11)
I2C0_SCL: U1.2 (GPIO5)
I2C0_SDA: U1.1 (GPIO4)
I2S_BCLK: U1.3 (GPIO6)
I2S_DIN: U1.7 (GPIO9)
I2S_DOUT: U1.6 (GPIO8)
I2S_LRCLK: U1.4 (GPIO7)
I2S_MCLK: U1.21 (GPIO21)
MUX_ST: U1.55 (GPIO44/ADC4)
PGOOD_N: U1.53 (GPIO42/ADC2)
QSPI_SS: R5.1, U1.75 (~QSPI_SS)
RUN: SW2.1, U1.35 (RUN)
SD_CD: U1.20 (GPIO20)
SD_CS: U1.37 (GPIO29)
SD_MISO: U1.36 (GPIO28)
SD_MOSI: U1.39 (GPIO31)
SD_SCK: U1.38 (GPIO30)
STATUS_LED: R6.1, U1.58 (GPIO47/ADC7)
STATUS_LED_A: D1.2 (A), R6.2
SWCLK: U1.33 (SWCLK)
SWDIO: U1.34 (SWDIO)
TOUCH_IRQ: U1.28 (GPIO27)
UART0_RX: U1.78 (GPIO1)
UART0_TX: U1.77 (GPIO0)
USB_DM: R2.2
USB_DM_MCU: R2.1, U1.66 (USB_DM)
USB_DP: R1.2
USB_DP_MCU: R1.1, U1.67 (USB_DP)
VBAT_SENSE: U1.49 (GPIO40/ADC0)
VBUS_SENSE: U1.54 (GPIO43/ADC3)
VREG_AVDD: C3.1, R3.2, U1.61 (VREG_AVDD)
VREG_LX: L1.1, U1.63 (VREG_LX)
VSYS_SENSE: U1.52 (GPIO41/ADC1)
XIN: C5.1, U1.30 (XIN), Y1.1
XOUT: R4.1, U1.31 (XOUT)
XTAL_OUT: C6.1, R4.2, Y1.3

Notes on the sheet:
RP2354B core. Follows Raspberry Pi 'Hardware design with RP2350' (Aug 2026) and Proton Rev4. No external flash: the RP2354B has 2 MB in package, so QSPI SD0-SD3 and SCLK stay unconnected. QSPI_SS keeps only the BOOTSEL path through 1k, as the guide requires. Regulator: L1 and capacitor values follo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
