Samprab06/PiPod/hardware/02_usb_power_entry.kicad_sch

## KiCad design hardware/02_usb_power_entry.kicad_sch (2026-11-02)

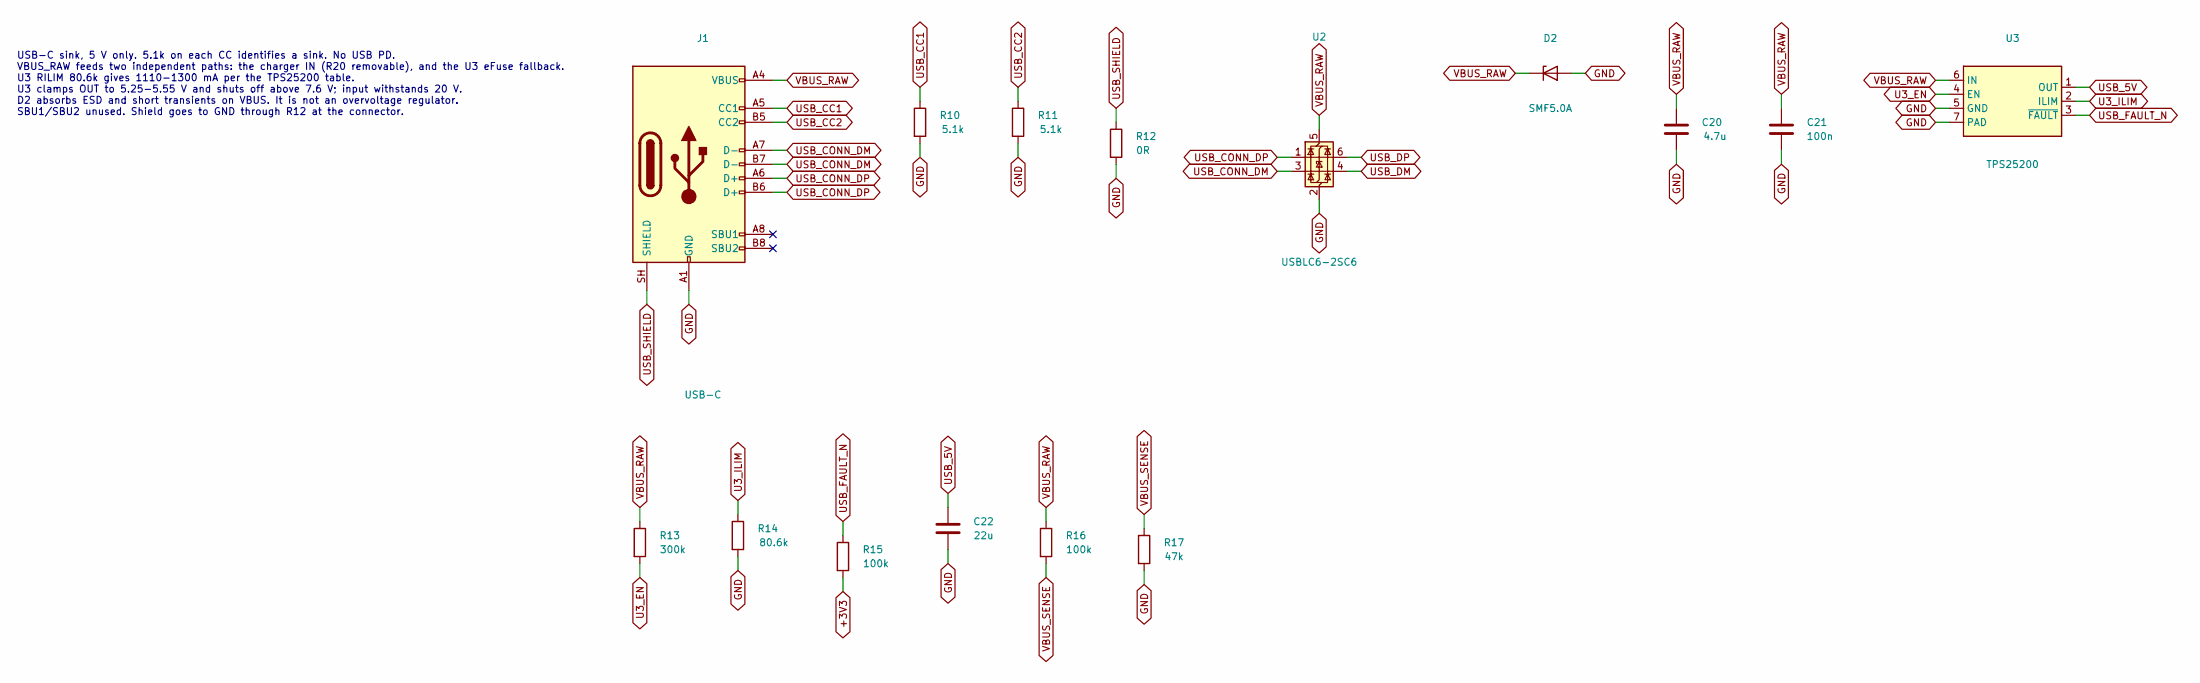
[picture p5: schematic 02_usb_power_entry.kicad_sch]

Parts:
C20: 4.7u; C_0603_1608Metric; MPN C0603C475K8PACTU
C21: 100n; C_0603_1608Metric; MPN C0603C104K4RACTU
C22: 22u; C_0805_2012Metric; MPN LMK212BJ226MG-T
D2: SMF5.0A; D_SMF; MPN SMF5.0A
J1: USB-C; USB_C_Receptacle_GCT_USB4105-xx-A_16P_TopMnt_Horizontal; MPN USB4105-GF-A
R10, R11: 5.1k; R_0603_1608Metric; MPN RC0603FR-075K1L
R12: 0R; R_0603_1608Metric; MPN RC0603JR-070RL
R13: 300k; R_0603_1608Metric; MPN RC0603FR-07300KL
R14: 80.6k; R_0603_1608Metric; MPN RC0603FR-0780K6L
R15, R16: 100k; R_0603_1608Metric; MPN RC0603FR-07100KL
R17: 47k; R_0603_1608Metric; MPN RC0603FR-0747KL
U2: USBLC6-2SC6; SOT-23-6; MPN USBLC6-2SC6
U3: TPS25200; WSON-6-1EP_2x2mm_P0.65mm_EP1x1.6mm; MPN TPS25200DRVR

Connections:
+3V3: R15.2
GND: C20.2, C21.2, C22.2, D2.2 (A), J1.A1 (GND), J1.A12 (GND), J1.B1 (GND), J1.B12 (GND), R10.2, R11.2, R12.2, R14.2, R17.2, U2.2 (GND), U3.5 (GND), U3.7 (PAD)
U3_EN: R13.2, U3.4 (EN)
U3_ILIM: R14.1, U3.2 (ILIM)
USB_5V: C22.1, U3.1 (OUT)
USB_CC1: J1.A5 (CC1), R10.1
USB_CC2: J1.B5 (CC2), R11.1
USB_CONN_DM: J1.A7 (D-), J1.B7 (D-), U2.3 (I/O2)
USB_CONN_DP: J1.A6 (D+), J1.B6 (D+), U2.1 (I/O1)
USB_DM: U2.4 (I/O2)
USB_DP: U2.6 (I/O1)
USB_FAULT_N: R15.1, U3.3 (~FAULT)
USB_SHIELD: J1.SH (SHIELD), R12.1
VBUS_RAW: C20.1, C21.1, D2.1 (K), J1.A4 (VBUS), J1.A9 (VBUS), J1.B4 (VBUS), J1.B9 (VBUS), R13.1, R16.1, U2.5 (VBUS), U3.6 (IN)
VBUS_SENSE: R16.2, R17.1

Notes on the sheet:
USB-C sink, 5 V only. 5.1k on each CC identifies a sink. No USB PD. VBUS_RAW feeds two independent paths: the charger IN (R20 removable), and the U3 eFuse fallback. U3 RILIM 80.6k gives 1110-1300 mA per the TPS25200 table. U3 clamps OUT to 5.25-5.55 V and shuts off above 7.6 V; input withstands 20 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
