Samprab06/PiPod/hardware/03_battery_charging.kicad_sch

## KiCad design hardware/03_battery_charging.kicad_sch (2026-11-02)

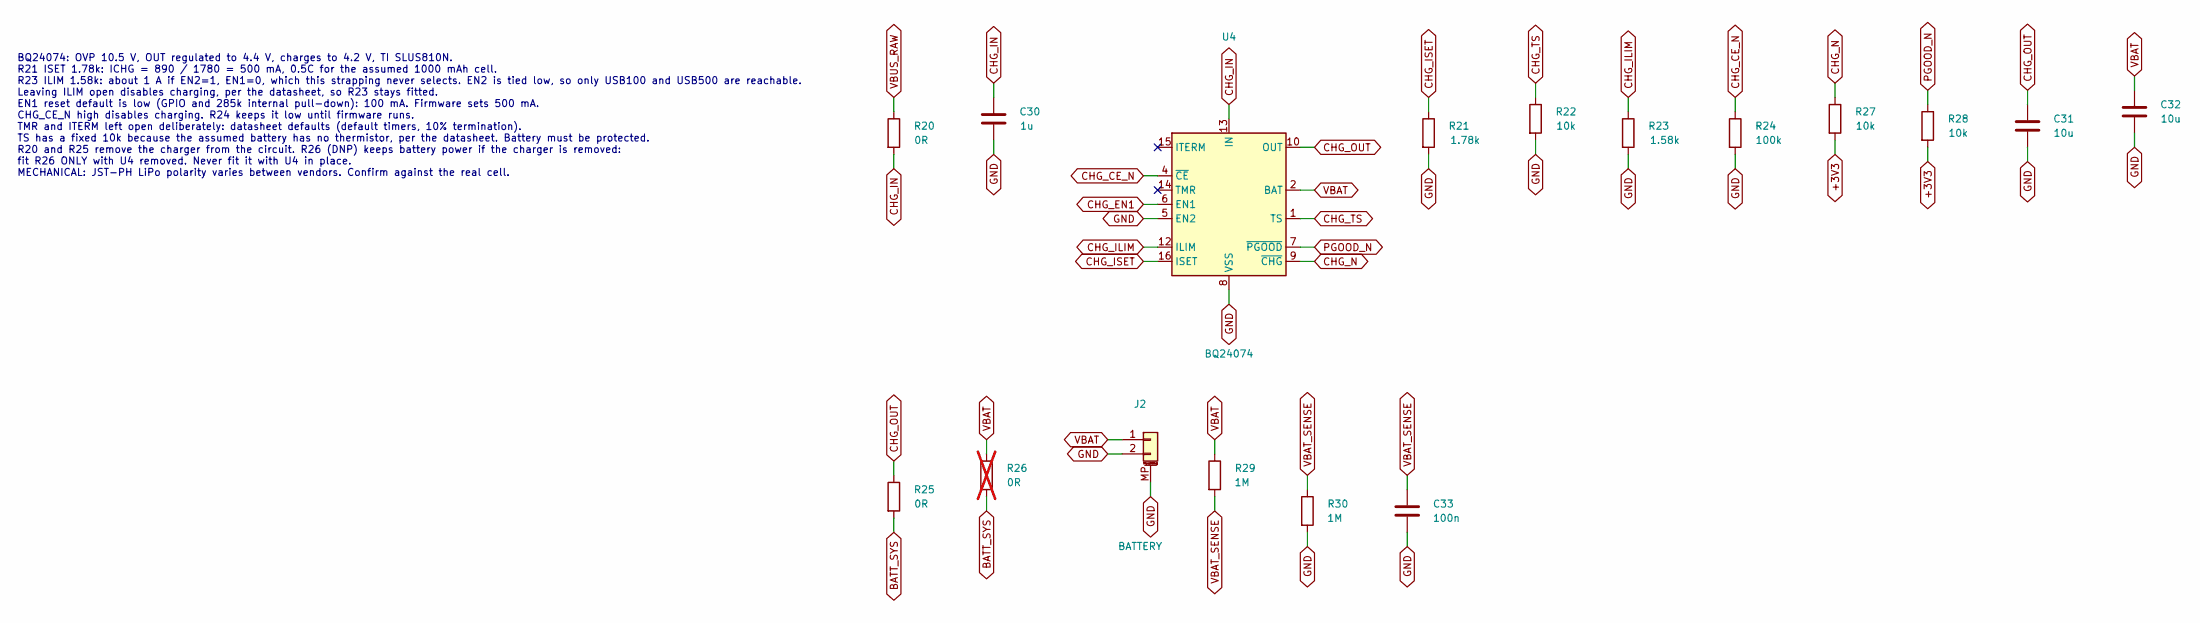
[picture p6: schematic 03_battery_charging.kicad_sch]

Parts:
C30: 1u; C_0603_1608Metric; MPN C0603C105K4RACTU
C31, C32: 10u; C_0805_2012Metric; MPN EMK212ABJ106KD-T
C33: 100n; C_0603_1608Metric; MPN C0603C104K4RACTU
J2: BATTERY; JST_PH_S2B-PH-SM4-TB_1x02-1MP_P2.00mm_Horizontal; MPN S2B-PH-SM4-TB(LF)(SN)
R20, R25: 0R; R_0805_2012Metric; MPN RC0805JR-070RL
R21: 1.78k; R_0603_1608Metric; MPN RC0603FR-071K78L
R22, R27, R28: 10k; R_0603_1608Metric; MPN RC0603FR-0710KL
R23: 1.58k; R_0603_1608Metric; MPN RC0603FR-071K58L
R24: 100k; R_0603_1608Metric; MPN RC0603FR-07100KL
R26: 0R; R_0805_2012Metric; MPN RC0805JR-070RL; not fitted
R29, R30: 1M; R_0603_1608Metric; MPN RC0603FR-071ML
U4: BQ24074; VQFN-16-1EP_3x3mm_P0.5mm_EP1.6x1.6mm; MPN BQ24074RGTR

Connections:
+3V3: R27.2, R28.2
BATT_SYS: R25.2, R26.2
CHG_CE_N: R24.1, U4.4 (~CE)
CHG_EN1: U4.6 (EN1)
CHG_ILIM: R23.1, U4.12 (ILIM)
CHG_IN: C30.1, R20.2, U4.13 (IN)
CHG_ISET: R21.1, U4.16 (ISET)
CHG_N: R27.1, U4.9 (~CHG)
CHG_OUT: C31.1, R25.1, U4.10 (OUT), U4.11 (OUT)
CHG_TS: R22.1, U4.1 (TS)
GND: C30.2, C31.2, C32.2, C33.2, J2.2, J2.MP (MountPin), R21.2, R22.2, R23.2, R24.2, R30.2, U4.5 (EN2), U4.8 (VSS), U4.17 (VSS)
PGOOD_N: R28.1, U4.7 (~PGOOD)
VBAT: C32.1, J2.1, R26.1, R29.1, U4.2 (BAT), U4.3 (BAT)
VBAT_SENSE: C33.1, R29.2, R30.1
VBUS_RAW: R20.1

Notes on the sheet:
BQ24074: OVP 10.5 V, OUT regulated to 4.4 V, charges to 4.2 V, TI SLUS810N. R21 ISET 1.78k: ICHG = 890 / 1780 = 500 mA, 0.5C for the assumed 1000 mAh cell. R23 ILIM 1.58k: about 1 A if EN2=1, EN1=0, which this strapping never selects. EN2 is tied low, so only USB100 and USB500 are reachable. Leavin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
