Samprab06/PiPod/hardware/04_power_selection_regulation.kicad_sch

## KiCad design hardware/04_power_selection_regulation.kicad_sch (2026-11-02)

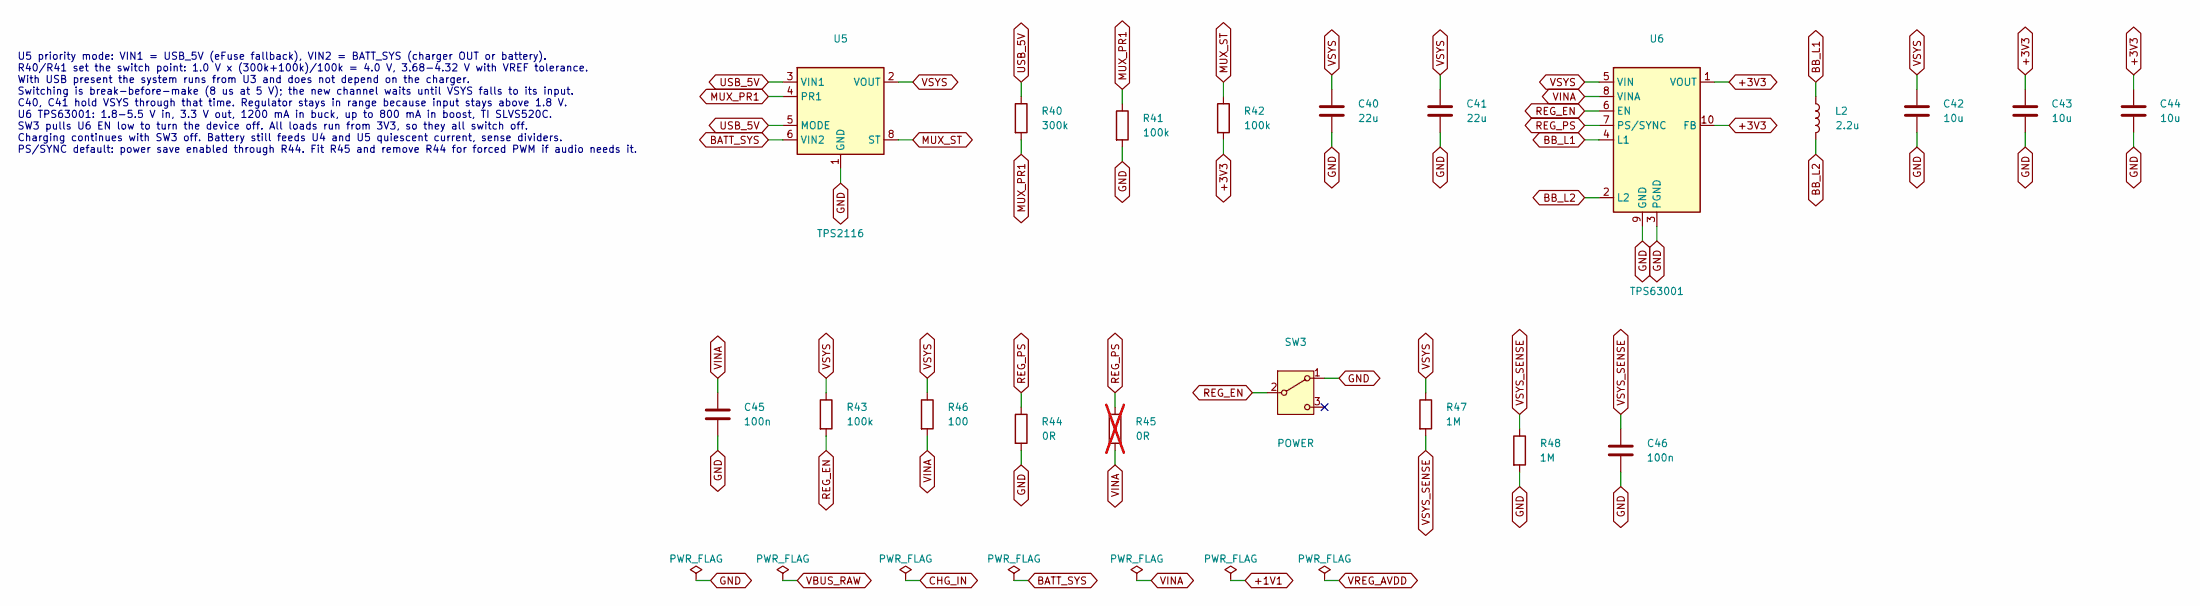
[picture p7: schematic 04_power_selection_regulation.kicad_sch]

Parts:
C40, C41: 22u; C_0805_2012Metric; MPN LMK212BJ226MG-T
C42, C43, C44: 10u; C_0805_2012Metric; MPN EMK212ABJ106KD-T
C45, C46: 100n; C_0603_1608Metric; MPN C0603C104K4RACTU
L2: 2.2u; L_1210_3225Metric; MPN DFE322512F-2R2M=P2
R40: 300k; R_0603_1608Metric; MPN RC0603FR-07300KL
R41, R42, R43: 100k; R_0603_1608Metric; MPN RC0603FR-07100KL
R44: 0R; R_0603_1608Metric; MPN RC0603JR-070RL
R45: 0R; R_0603_1608Metric; MPN RC0603JR-070RL; not fitted
R46: 100; R_0603_1608Metric; MPN RC0603FR-07100RL
R47, R48: 1M; R_0603_1608Metric; MPN RC0603FR-071ML
SW3: POWER; SW_SPDT_CK_JS102011SAQN; MPN JS102011SAQN
U5: TPS2116; SOT-583-8; MPN TPS2116DRLR
U6: TPS63001; Texas_DRC0010J; MPN TPS63001DRCR

Connections:
+3V3: C43.1, C44.1, R42.2, U6.1 (VOUT), U6.10 (FB)
BATT_SYS: U5.6 (VIN2)
BB_L1: L2.1, U6.4 (L1)
BB_L2: L2.2, U6.2 (L2)
GND: C40.2, C41.2, C42.2, C43.2, C44.2, C45.2, C46.2, R41.2, R44.2, R48.2, SW3.1 (A), U5.1 (GND), U6.3 (PGND), U6.9 (GND), U6.11 (PGND)
MUX_PR1: R40.2, R41.1, U5.4 (PR1)
MUX_ST: R42.1, U5.8 (ST)
REG_EN: R43.2, SW3.2 (B), U6.6 (EN)
REG_PS: R44.1, R45.1, U6.7 (PS/SYNC)
USB_5V: R40.1, U5.3 (VIN1), U5.5 (MODE)
VINA: C45.1, R45.2, R46.2, U6.8 (VINA)
VSYS: C40.1, C41.1, C42.1, R43.1, R46.1, R47.1, U5.2 (VOUT), U5.7 (VOUT), U6.5 (VIN)
VSYS_SENSE: C46.1, R47.2, R48.1

Notes on the sheet:
U5 priority mode: VIN1 = USB_5V (eFuse fallback), VIN2 = BATT_SYS (charger OUT or battery). R40/R41 set the switch point: 1.0 V x (300k+100k)/100k = 4.0 V, 3.68-4.32 V with VREF tolerance. With USB present the system runs from U3 and does not depend on the charger. Switching is break-before-make (8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
