Samprab06/PiPod/hardware/05_display.kicad_sch

## KiCad design hardware/05_display.kicad_sch (2026-11-02)

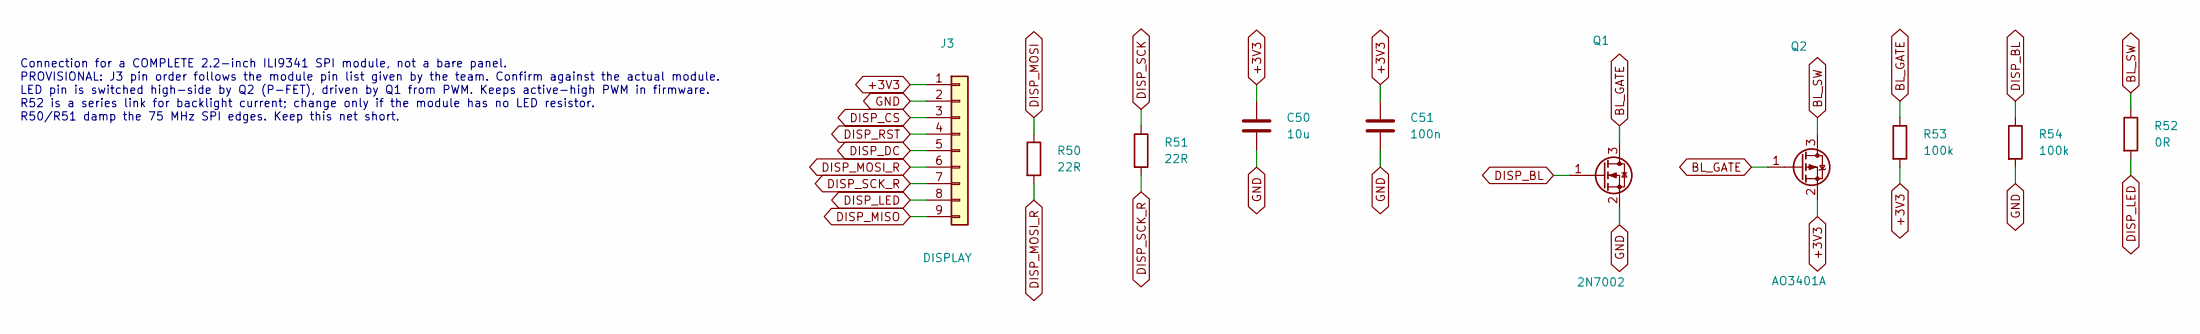
[picture p8: schematic 05_display.kicad_sch]

Parts:
C50: 10u; C_0805_2012Metric; MPN EMK212ABJ106KD-T
C51: 100n; C_0603_1608Metric; MPN C0603C104K4RACTU
J3: DISPLAY; PinSocket_1x09_P2.54mm_Vertical; MPN PPTC091LFBN-RC
Q1: 2N7002; SOT-23; MPN 2N7002
Q2: AO3401A; SOT-23; MPN AO3401A
R50, R51: 22R; R_0603_1608Metric; MPN RC0603FR-0722RL
R52: 0R; R_0603_1608Metric; MPN RC0603JR-070RL
R53, R54: 100k; R_0603_1608Metric; MPN RC0603FR-07100KL

Connections:
+3V3: C50.1, C51.1, J3.1, Q2.2 (S), R53.2
BL_GATE: Q1.3 (D), Q2.1 (G), R53.1
BL_SW: Q2.3 (D), R52.1
DISP_BL: Q1.1 (G), R54.1
DISP_CS: J3.3
DISP_DC: J3.5
DISP_LED: J3.8, R52.2
DISP_MISO: J3.9
DISP_MOSI: R50.1
DISP_MOSI_R: J3.6, R50.2
DISP_RST: J3.4
DISP_SCK: R51.1
DISP_SCK_R: J3.7, R51.2
GND: C50.2, C51.2, J3.2, Q1.2 (S), R54.2

Notes on the sheet:
Connection for a COMPLETE 2.2-inch ILI9341 SPI module, not a bare panel. PROVISIONAL: J3 pin order follows the module pin list given by the team. Confirm against the actual module. LED pin is switched high-side by Q2 (P-FET), driven by Q1 from PWM. Keeps active-high PWM in firmware. R52 is a series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
