Samprab06/PiPod/hardware/06_microsd.kicad_sch

## KiCad design hardware/06_microsd.kicad_sch (2026-11-02)

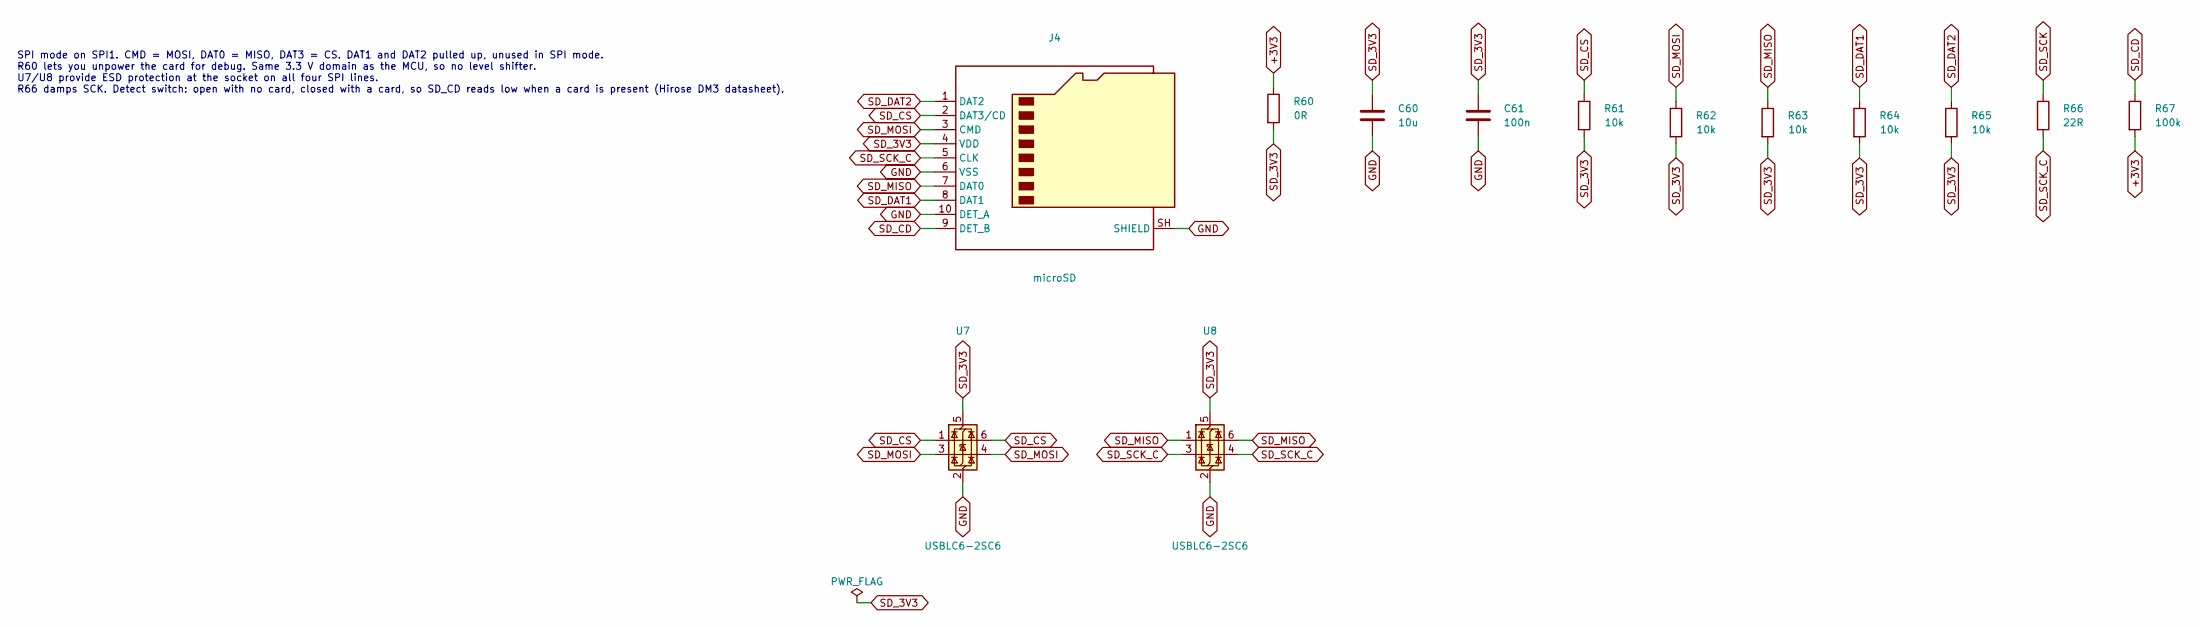
[picture p9: schematic 06_microsd.kicad_sch]

Parts:
C60: 10u; C_0805_2012Metric; MPN EMK212ABJ106KD-T
C61: 100n; C_0603_1608Metric; MPN C0603C104K4RACTU
J4: microSD; microSD_HC_Hirose_DM3AT-SF-PEJM5; MPN DM3AT-SF-PEJM5(40)
R60: 0R; R_0603_1608Metric; MPN RC0603JR-070RL
R61, R62, R63, R64, R65: 10k; R_0603_1608Metric; MPN RC0603FR-0710KL
R66: 22R; R_0603_1608Metric; MPN RC0603FR-0722RL
R67: 100k; R_0603_1608Metric; MPN RC0603FR-07100KL
U7, U8: USBLC6-2SC6; SOT-23-6; MPN USBLC6-2SC6

Connections:
+3V3: R60.1, R67.2
GND: C60.2, C61.2, J4.6 (VSS), J4.10 (DET_A), J4.SH (SHIELD), U7.2 (GND), U8.2 (GND)
SD_3V3: C60.1, C61.1, J4.4 (VDD), R60.2, R61.2, R62.2, R63.2, R64.2, R65.2, U7.5 (VBUS), U8.5 (VBUS)
SD_CD: J4.9 (DET_B), R67.1
SD_CS: J4.2 (DAT3/CD), R61.1, U7.1 (I/O1), U7.6 (I/O1)
SD_DAT1: J4.8 (DAT1), R64.1
SD_DAT2: J4.1 (DAT2), R65.1
SD_MISO: J4.7 (DAT0), R63.1, U8.1 (I/O1), U8.6 (I/O1)
SD_MOSI: J4.3 (CMD), R62.1, U7.3 (I/O2), U7.4 (I/O2)
SD_SCK: R66.1
SD_SCK_C: J4.5 (CLK), R66.2, U8.3 (I/O2), U8.4 (I/O2)

Notes on the sheet:
SPI mode on SPI1. CMD = MOSI, DAT0 = MISO, DAT3 = CS. DAT1 and DAT2 pulled up, unused in SPI mode. R60 lets you unpower the card for debug. Same 3.3 V domain as the MCU, so no level shifter. U7/U8 provide ESD protection at the socket on all four SPI lines. R66 damps SCK. Detect switch: open with no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
