Samprab06/PiPod/hardware/07_audio_codec.kicad_sch

## KiCad design hardware/07_audio_codec.kicad_sch (2026-11-02)

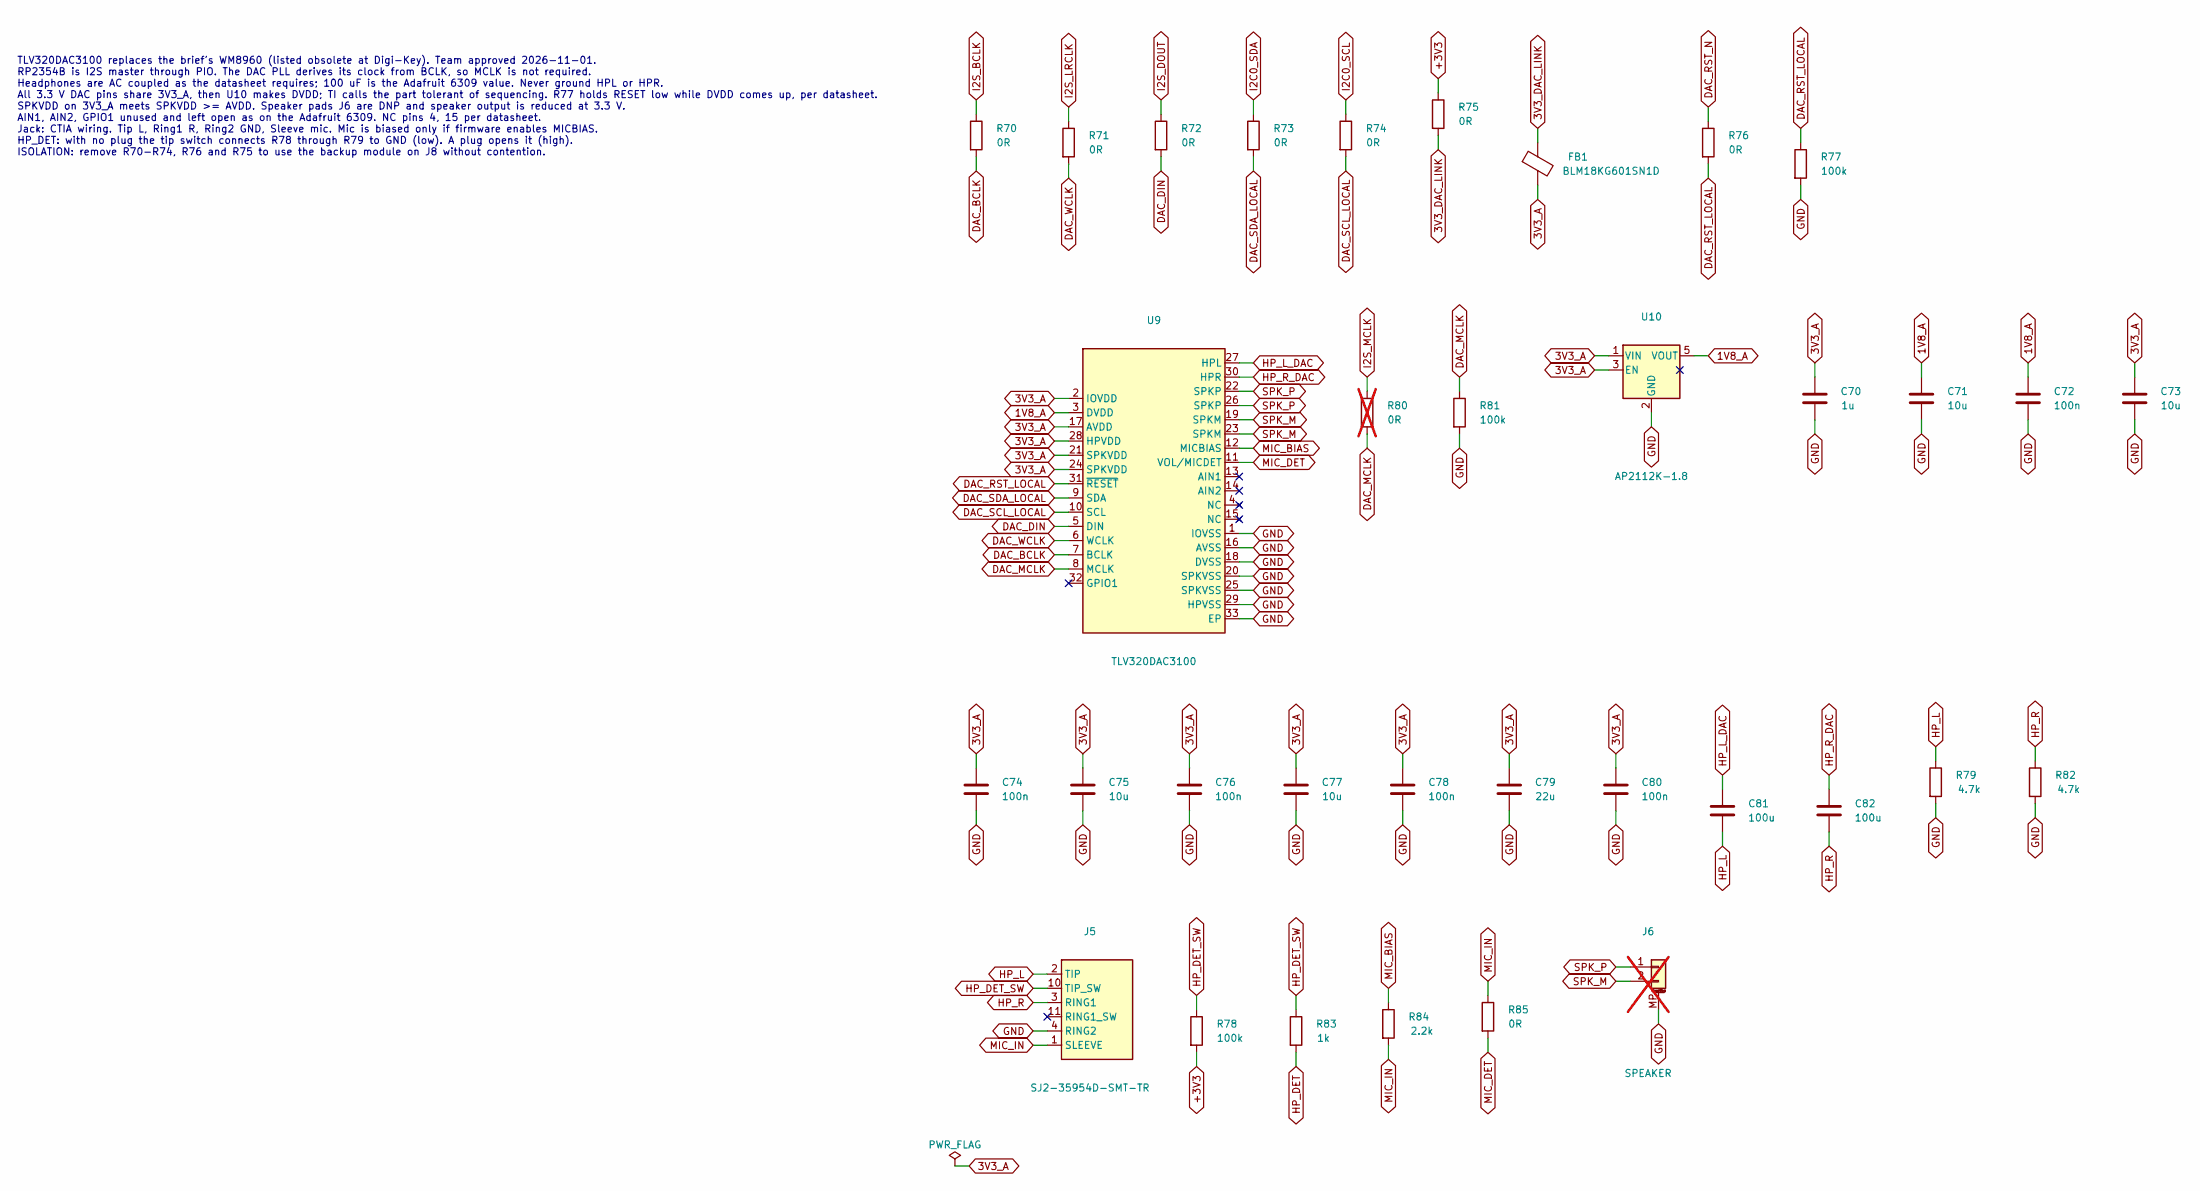
[picture p10: schematic 07_audio_codec.kicad_sch]

Parts:
C70: 1u; C_0603_1608Metric; MPN C0603C105K4RACTU
C71, C73, C75, C77: 10u; C_0805_2012Metric; MPN EMK212ABJ106KD-T
C72, C74, C76, C78, C80: 100n; C_0603_1608Metric; MPN C0603C104K4RACTU
C79: 22u; C_0805_2012Metric; MPN LMK212BJ226MG-T
C81, C82: 100u; C_1210_3225Metric; MPN LMK325BJ107MM-T
FB1: BLM18KG601SN1D; L_0603_1608Metric; MPN BLM18KG601SN1D
J5: SJ2-35954D-SMT-TR; Jack_3.5mm_SameSky_SJ2-35954D-SMT; MPN SJ2-35954D-SMT-TR
J6: SPEAKER; JST_PH_S2B-PH-SM4-TB_1x02-1MP_P2.00mm_Horizontal; MPN S2B-PH-SM4-TB(LF)(SN); not fitted
R70, R71, R72, R73, R74, R75, R76, R85: 0R; R_0603_1608Metric; MPN RC0603JR-070RL
R77, R78, R81: 100k; R_0603_1608Metric; MPN RC0603FR-07100KL
R79, R82: 4.7k; R_0603_1608Metric; MPN RC0603FR-074K7L
R80: 0R; R_0603_1608Metric; MPN RC0603JR-070RL; not fitted
R83: 1k; R_0603_1608Metric; MPN RC0603FR-071KL
R84: 2.2k; R_0603_1608Metric; MPN RC0603FR-072K2L
U9: TLV320DAC3100; Texas_RHB0032E_VQFN-32-1EP_5x5mm_P0.5mm_EP3.45x3.45mm; MPN TLV320DAC3100IRHBR
U10: AP2112K-1.8; SOT-23-5; MPN AP2112K-1.8TRG1

Connections:
1V8_A: C71.1, C72.1, U9.3 (DVDD), U10.5 (VOUT)
3V3_A: C70.1, C73.1, C74.1, C75.1, C76.1, C77.1, C78.1, C79.1, C80.1, FB1.2, U9.2 (IOVDD), U9.17 (AVDD), U9.21 (SPKVDD), U9.24 (SPKVDD), U9.28 (HPVDD), U10.1 (VIN), U10.3 (EN)
3V3_DAC_LINK: FB1.1, R75.2
+3V3: R75.1, R78.2
DAC_BCLK: R70.2, U9.7 (BCLK)
DAC_DIN: R72.2, U9.5 (DIN)
DAC_MCLK: R80.2, R81.1, U9.8 (MCLK)
DAC_RST_LOCAL: R76.2, R77.1, U9.31 (~RESET)
DAC_RST_N: R76.1
DAC_SCL_LOCAL: R74.2, U9.10 (SCL)
DAC_SDA_LOCAL: R73.2, U9.9 (SDA)
DAC_WCLK: R71.2, U9.6 (WCLK)
GND: C70.2, C71.2, C72.2, C73.2, C74.2, C75.2, C76.2, C77.2, C78.2, C79.2, C80.2, J5.4 (RING2), J6.MP (MountPin), R77.2, R79.2, R81.2, R82.2, U9.1 (IOVSS), U9.16 (AVSS), U9.18 (DVSS), U9.20 (SPKVSS), U9.25 (SPKVSS), U9.29 (HPVSS), U9.33 (EP), U10.2 (GND)
HP_DET: R83.2
HP_DET_SW: J5.10 (TIP_SW), R78.1, R83.1
HP_L: C81.2, J5.2 (TIP), R79.1
HP_L_DAC: C81.1, U9.27 (HPL)
HP_R: C82.2, J5.3 (RING1), R82.1
HP_R_DAC: C82.1, U9.30 (HPR)
I2C0_SCL: R74.1
I2C0_SDA: R73.1
I2S_BCLK: R70.1
I2S_DOUT: R72.1
I2S_LRCLK: R71.1
I2S_MCLK: R80.1
MIC_BIAS: R84.1, U9.12 (MICBIAS)
MIC_DET: R85.2, U9.11 (VOL/MICDET)
MIC_IN: J5.1 (SLEEVE), R84.2, R85.1
SPK_M: J6.2, U9.19 (SPKM), U9.23 (SPKM)
SPK_P: J6.1, U9.22 (SPKP), U9.26 (SPKP)

Notes on the sheet:
TLV320DAC3100 replaces the brief's WM8960 (listed obsolete at Digi-Key). Team approved 2026-11-01. RP2354B is I2S master through PIO. The DAC PLL derives its clock from BCLK, so MCLK is not required. Headphones are AC coupled as the datasheet requires; 100 uF is the Adafruit 6309 value. Never groun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
