Samprab06/PiPod/hardware/08_capacitive_wheel.kicad_sch

## KiCad design hardware/08_capacitive_wheel.kicad_sch (2026-11-02)

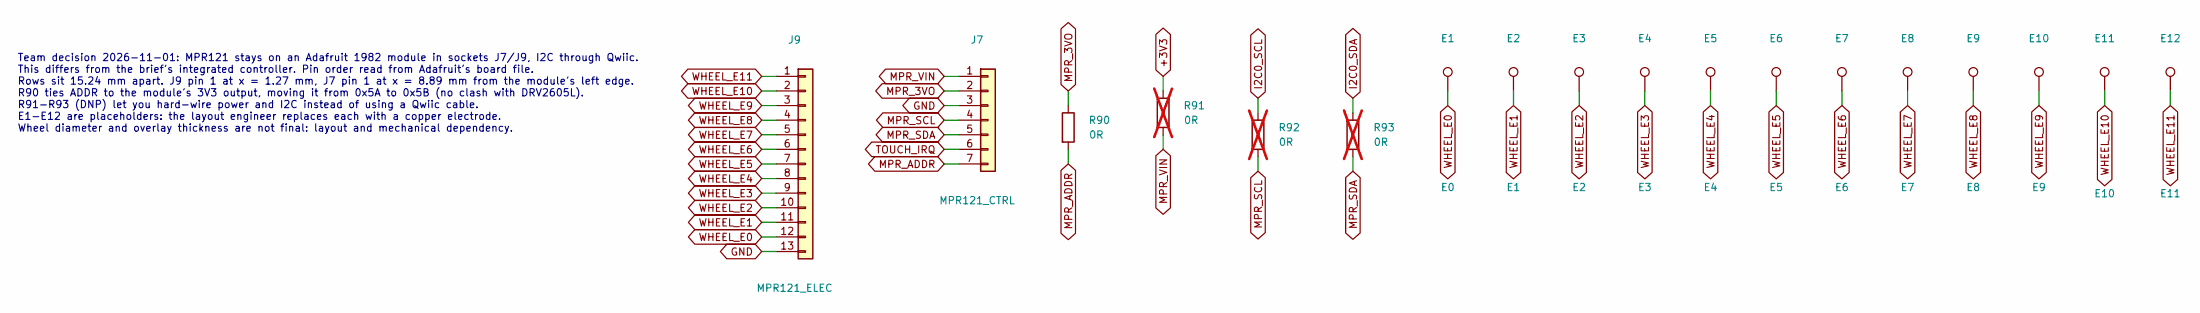
[picture p11: schematic 08_capacitive_wheel.kicad_sch]

Parts:
E1: E0; WheelElectrode_Placeholder
E2: E1; WheelElectrode_Placeholder
E3: E2; WheelElectrode_Placeholder
E4: E3; WheelElectrode_Placeholder
E5: E4; WheelElectrode_Placeholder
E6: E5; WheelElectrode_Placeholder
E7: E6; WheelElectrode_Placeholder
E8: E7; WheelElectrode_Placeholder
E9: E8; WheelElectrode_Placeholder
E10: E9; WheelElectrode_Placeholder
E11: E10; WheelElectrode_Placeholder
E12: E11; WheelElectrode_Placeholder
J7: MPR121_CTRL; PinSocket_1x07_P2.54mm_Vertical; MPN PPTC071LFBN-RC
J9: MPR121_ELEC; PinSocket_1x13_P2.54mm_Vertical; MPN PPTC131LFBN-RC
R90: 0R; R_0603_1608Metric; MPN RC0603JR-070RL
R91, R92, R93: 0R; R_0603_1608Metric; MPN RC0603JR-070RL; not fitted

Connections:
+3V3: R91.1
GND: J7.3, J9.13
I2C0_SCL: R92.1
I2C0_SDA: R93.1
MPR_3VO: J7.2, R90.1
MPR_ADDR: J7.7, R90.2
MPR_SCL: J7.4, R92.2
MPR_SDA: J7.5, R93.2
MPR_VIN: J7.1, R91.2
TOUCH_IRQ: J7.6
WHEEL_E0: E1.1, J9.12
WHEEL_E1: E2.1, J9.11
WHEEL_E2: E3.1, J9.10
WHEEL_E3: E4.1, J9.9
WHEEL_E4: E5.1, J9.8
WHEEL_E5: E6.1, J9.7
WHEEL_E6: E7.1, J9.6
WHEEL_E7: E8.1, J9.5
WHEEL_E8: E9.1, J9.4
WHEEL_E9: E10.1, J9.3
WHEEL_E10: E11.1, J9.2
WHEEL_E11: E12.1, J9.1

Notes on the sheet:
Team decision 2026-11-01: MPR121 stays on an Adafruit 1982 module in sockets J7/J9, I2C through Qwiic. This differs from the brief's integrated controller. Pin order read from Adafruit's board file. Rows sit 15.24 mm apart. J9 pin 1 at x = 1.27 mm, J7 pin 1 at x = 8.89 mm from the module's left edg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
