Samprab06/PiPod/hardware/09_buttons_haptics.kicad_sch

## KiCad design hardware/09_buttons_haptics.kicad_sch (2026-11-02)

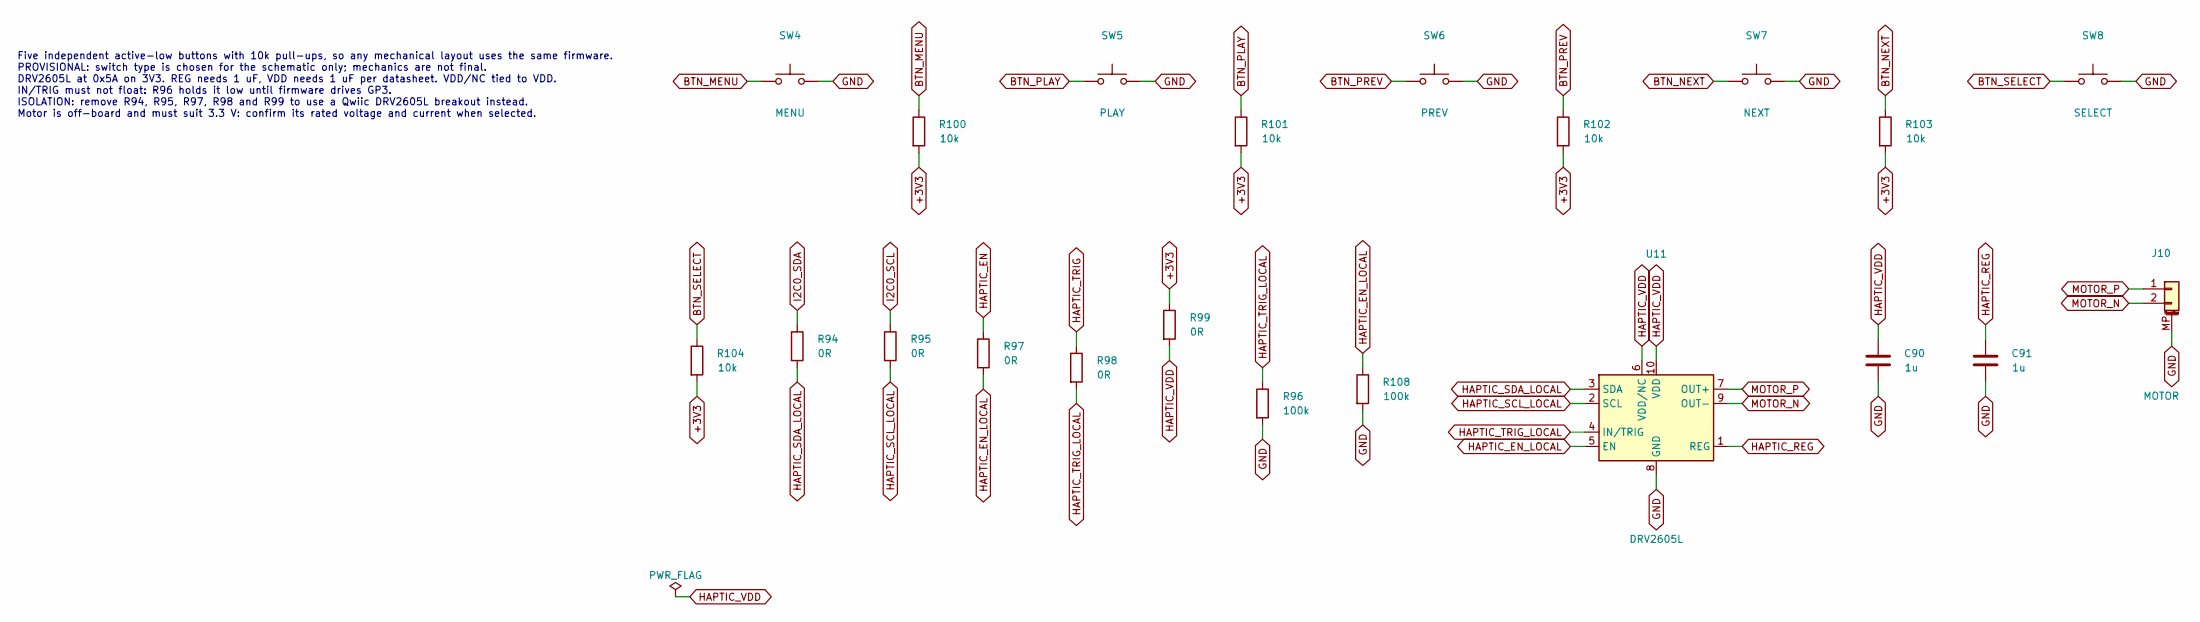
[picture p12: schematic 09_buttons_haptics.kicad_sch]

Parts:
C90, C91: 1u; C_0603_1608Metric; MPN C0603C105K4RACTU
J10: MOTOR; JST_SH_SM02B-SRSS-TB_1x02-1MP_P1.00mm_Horizontal; MPN SM02B-SRSS-TB(LF)(SN)
R94, R95, R97, R98, R99: 0R; R_0603_1608Metric; MPN RC0603JR-070RL
R96, R108: 100k; R_0603_1608Metric; MPN RC0603FR-07100KL
R100, R101, R102, R103, R104: 10k; R_0603_1608Metric; MPN RC0603FR-0710KL
SW4: MENU; SW_SPST_PTS647_Sx38; MPN PTS647SM38SMTR2LFS
SW5: PLAY; SW_SPST_PTS647_Sx38; MPN PTS647SM38SMTR2LFS
SW6: PREV; SW_SPST_PTS647_Sx38; MPN PTS647SM38SMTR2LFS
SW7: NEXT; SW_SPST_PTS647_Sx38; MPN PTS647SM38SMTR2LFS
SW8: SELECT; SW_SPST_PTS647_Sx38; MPN PTS647SM38SMTR2LFS
U11: DRV2605L; TSSOP-10_3x3mm_P0.5mm; MPN DRV2605LDGST

Connections:
+3V3: R99.1, R100.2, R101.2, R102.2, R103.2, R104.2
BTN_MENU: R100.1, SW4.1
BTN_NEXT: R103.1, SW7.1
BTN_PLAY: R101.1, SW5.1
BTN_PREV: R102.1, SW6.1
BTN_SELECT: R104.1, SW8.1
GND: C90.2, C91.2, J10.MP (MountPin), R96.2, R108.2, SW4.2, SW5.2, SW6.2, SW7.2, SW8.2, U11.8 (GND)
HAPTIC_EN: R97.1
HAPTIC_EN_LOCAL: R97.2, R108.1, U11.5 (EN)
HAPTIC_REG: C91.1, U11.1 (REG)
HAPTIC_SCL_LOCAL: R95.2, U11.2 (SCL)
HAPTIC_SDA_LOCAL: R94.2, U11.3 (SDA)
HAPTIC_TRIG: R98.1
HAPTIC_TRIG_LOCAL: R96.1, R98.2, U11.4 (IN/TRIG)
HAPTIC_VDD: C90.1, R99.2, U11.6 (VDD/NC), U11.10 (VDD)
I2C0_SCL: R95.1
I2C0_SDA: R94.1
MOTOR_N: J10.2, U11.9 (OUT-)
MOTOR_P: J10.1, U11.7 (OUT+)

Notes on the sheet:
Five independent active-low buttons with 10k pull-ups, so any mechanical layout uses the same firmware. PROVISIONAL: switch type is chosen for the schematic only; mechanics are not final. DRV2605L at 0x5A on 3V3. REG needs 1 uF, VDD needs 1 uF per datasheet. VDD/NC tied to VDD. IN/TRIG must not flo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
