Samprab06/PiPod/hardware/10_expansion_backup.kicad_sch

## KiCad design hardware/10_expansion_backup.kicad_sch (2026-11-02)

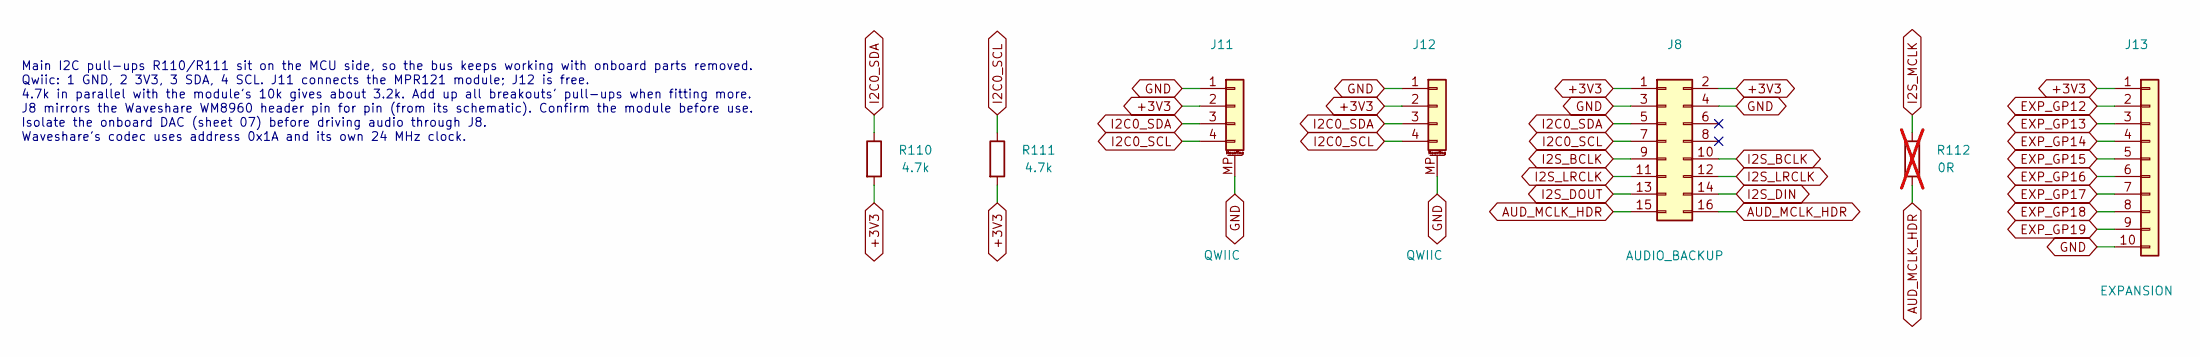
[picture p13: schematic 10_expansion_backup.kicad_sch]

Parts:
J8: AUDIO_BACKUP; PinHeader_2x08_P2.54mm_Vertical; MPN PREC008DAAN-RC
J11, J12: QWIIC; JST_SH_SM04B-SRSS-TB_1x04-1MP_P1.00mm_Horizontal; MPN SM04B-SRSS-TB(LF)(SN)
J13: EXPANSION; PinHeader_1x10_P2.54mm_Vertical; MPN PREC010SAAN-RC
R110, R111: 4.7k; R_0603_1608Metric; MPN RC0603FR-074K7L
R112: 0R; R_0603_1608Metric; MPN RC0603JR-070RL; not fitted

Connections:
+3V3: J8.1, J8.2, J11.2, J12.2, J13.1, R110.2, R111.2
AUD_MCLK_HDR: J8.15, J8.16, R112.2
EXP_GP12: J13.2
EXP_GP13: J13.3
EXP_GP14: J13.4
EXP_GP15: J13.5
EXP_GP16: J13.6
EXP_GP17: J13.7
EXP_GP18: J13.8
EXP_GP19: J13.9
GND: J8.3, J8.4, J11.1, J11.MP (MountPin), J12.1, J12.MP (MountPin), J13.10
I2C0_SCL: J8.7, J11.4, J12.4, R111.1
I2C0_SDA: J8.5, J11.3, J12.3, R110.1
I2S_BCLK: J8.9, J8.10
I2S_DIN: J8.14
I2S_DOUT: J8.13
I2S_LRCLK: J8.11, J8.12
I2S_MCLK: R112.1

Notes on the sheet:
Main I2C pull-ups R110/R111 sit on the MCU side, so the bus keeps working with onboard parts removed. Qwiic: 1 GND, 2 3V3, 3 SDA, 4 SCL. J11 connects the MPR121 module; J12 is free. 4.7k in parallel with the module's 10k gives about 3.2k. Add up all breakouts' pull-ups when fitting more. J8 mirrors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
