Samprab06/PiPod/hardware/11_debug_testpoints.kicad_sch

## KiCad design hardware/11_debug_testpoints.kicad_sch (2026-11-02)

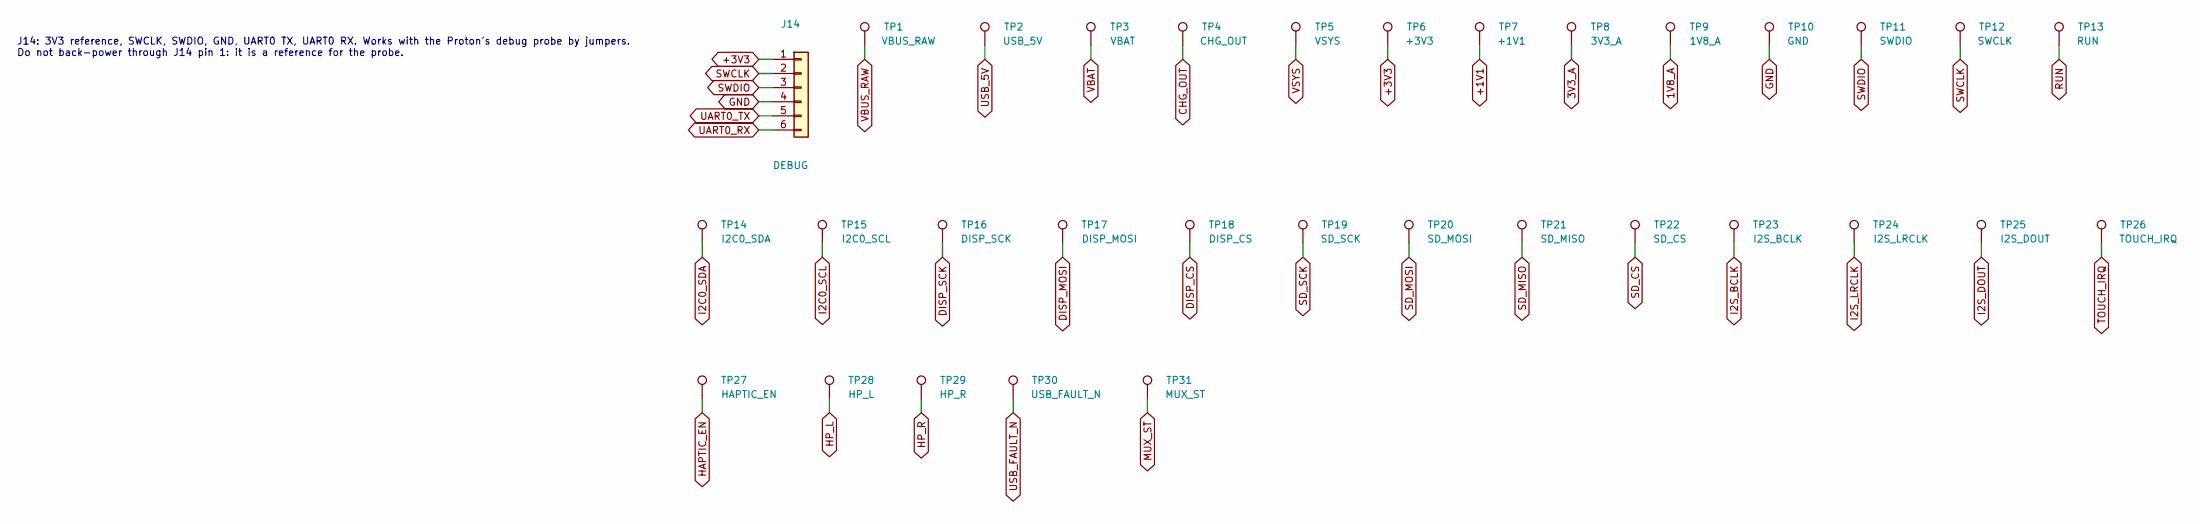
[picture p14: schematic 11_debug_testpoints.kicad_sch]

Parts:
J14: DEBUG; PinHeader_1x06_P2.54mm_Vertical; MPN PREC006SAAN-RC
TP1: VBUS_RAW; TestPoint_Pad_D1.5mm
TP2: USB_5V; TestPoint_Pad_D1.5mm
TP3: VBAT; TestPoint_Pad_D1.5mm
TP4: CHG_OUT; TestPoint_Pad_D1.5mm
TP5: VSYS; TestPoint_Pad_D1.5mm
TP6: +3V3; TestPoint_Pad_D1.5mm
TP7: +1V1; TestPoint_Pad_D1.5mm
TP8: 3V3_A; TestPoint_Pad_D1.5mm
TP9: 1V8_A; TestPoint_Pad_D1.5mm
TP10: GND; TestPoint_Pad_D1.5mm
TP11: SWDIO; TestPoint_Pad_D1.5mm
TP12: SWCLK; TestPoint_Pad_D1.5mm
TP13: RUN; TestPoint_Pad_D1.5mm
TP14: I2C0_SDA; TestPoint_Pad_D1.5mm
TP15: I2C0_SCL; TestPoint_Pad_D1.5mm
TP16: DISP_SCK; TestPoint_Pad_D1.5mm
TP17: DISP_MOSI; TestPoint_Pad_D1.5mm
TP18: DISP_CS; TestPoint_Pad_D1.5mm
TP19: SD_SCK; TestPoint_Pad_D1.5mm
TP20: SD_MOSI; TestPoint_Pad_D1.5mm
TP21: SD_MISO; TestPoint_Pad_D1.5mm
TP22: SD_CS; TestPoint_Pad_D1.5mm
TP23: I2S_BCLK; TestPoint_Pad_D1.5mm
TP24: I2S_LRCLK; TestPoint_Pad_D1.5mm
TP25: I2S_DOUT; TestPoint_Pad_D1.5mm
TP26: TOUCH_IRQ; TestPoint_Pad_D1.5mm
TP27: HAPTIC_EN; TestPoint_Pad_D1.5mm
TP28: HP_L; TestPoint_Pad_D1.5mm
TP29: HP_R; TestPoint_Pad_D1.5mm
TP30: USB_FAULT_N; TestPoint_Pad_D1.5mm
TP31: MUX_ST; TestPoint_Pad_D1.5mm

Connections:
1V8_A: TP9.1
3V3_A: TP8.1
+1V1: TP7.1
+3V3: J14.1, TP6.1
CHG_OUT: TP4.1
DISP_CS: TP18.1
DISP_MOSI: TP17.1
DISP_SCK: TP16.1
GND: J14.4, TP10.1
HAPTIC_EN: TP27.1
HP_L: TP28.1
HP_R: TP29.1
I2C0_SCL: TP15.1
I2C0_SDA: TP14.1
I2S_BCLK: TP23.1
I2S_DOUT: TP25.1
I2S_LRCLK: TP24.1
MUX_ST: TP31.1
RUN: TP13.1
SD_CS: TP22.1
SD_MISO: TP21.1
SD_MOSI: TP20.1
SD_SCK: TP19.1
SWCLK: J14.2, TP12.1
SWDIO: J14.3, TP11.1
TOUCH_IRQ: TP26.1
UART0_RX: J14.6
UART0_TX: J14.5
USB_5V: TP2.1
USB_FAULT_N: TP30.1
VBAT: TP3.1
VBUS_RAW: TP1.1
VSYS: TP5.1

Notes on the sheet:
J14: 3V3 reference, SWCLK, SWDIO, GND, UART0 TX, UART0 RX. Works with the Proton's debug probe by jumpers. Do not back-power through J14 pin 1: it is a reference for the probe.
