Samprab06/PiPod/(commit log)

2026-10-30 Add ILI9341 display driver and PiPod UI
    ILI9341 driver over SPI0 with DMA, partial window updates and backlight PWM.
    gfx renderer with dirty-rect merging and 16-row strips, plus generated Inter fonts.
    Menu, now-playing and settings screens with an input layer for buttons, UART keys
    and the MPR121 wheel.
    Demo app with a simulated library and audio load, wiring/API/performance docs and
    prebuilt firmware in dist/.
2026-10-30 added kicad project
2026-11-02 add full kicad schematic for rp2354b board, bom and integration docs
2026-11-02 add schematic generator scripts
